danny50167/Space-to-Touch/README.md

# Space-to-Touch

시각장애인을 위한 **전방 공간 정보 → 촉각 변환 장치**.
머리에 착용한 ToF 거리 센서 3개(가로 한 줄)가 머리 높이의 전방을 측정하고, 진동 모터 3개가 장애물의 **방향**(왼쪽 / 가운데 / 오른쪽)과 **거리**를 진동으로 알려준다.

> 흰지팡이는 바닥의 장애물은 잘 찾지만 **허리 위 장애물(간판, 선반, 열린 창문 등)** 은 감지하지 못한다.
> 이 장치는 지팡이를 대체하는 것이 아니라, 지팡이가 못 하는 부분을 **보완**하는 것을 목표로 한다.

## 시스템 구성

```
 [머리 유닛]                               [몸 유닛]
 VL53L1X ×3 ── TCA9548A ── 4선 케이블 ──── ESP32 DevKitC ── 진동 모터 모듈 ×3
 MPU-6050 (고개 각도) ──────┘                    ┆ Wi-Fi
 (3D 프린팅 브래킷)    (3.3V, GND, SDA, SCL)   맥북 (데이터 기록)    (MOSFET 내장, VCC·GND·IN)
```

보드는 처음에 Arduino Mega로 정했다가, 걸으면서 하는 실험의 데이터를 무선으로 받으려고 ESP32로 바꿨다 (11/10). Mega·Uno는 예비이고 펌웨어는 세 보드 모두에서 돌아간다. 사용법은 `docs/esp32.md`.

센서 번호와 모터 번호는 같은 규칙을 쓴다. 멀티플렉서 채널 번호도 같다.

```
 왼쪽   가운데   오른쪽
  0       1       2      ← 머리 높이 (가로 한 줄)
```

처음에는 3×2(위 줄 + 허리 높이 아래 줄)로 설계했다가 머리 높이만 보는 1×3으로 바꿨다. 이유와 한계는 `docs/design-notes.md` 1-3장.

## 폴더 구조

| 경로 | 내용 |
|---|---|
| `docs/roadmap.md` | 작업 순서대로 정리한 할 일 목록, 단계마다 남길 기록 |
| `docs/design-notes.md` | 핵심 설계 쟁점과 계산 (센서 각도, 모터 위치, 진동 표현 방식) |
| `docs/wiring.md` | 배선도와 전원 설계 |
| `docs/esp32.md` | ESP32 설치, 첫 업로드, 무선으로 데이터 받기 (맥북) |
| `docs/parts.md` | 준비물 목록 (전자 부품, 기구 부품, 실험 도구) |
| `docs/logbook-template.md` | 설계 일지 양식 |
| `firmware/00_i2c_scan` | 부품 확인: I2C 장치 검사, 진짜 VL53L1X인지 확인, 멀티플렉서 채널별 검사 |
| `firmware/01_single_sensor_test` | 센서 1개: 거리 모드 비교, 정확도 측정 |
| `firmware/02_three_sensors_mux` | 센서 3개 + 멀티플렉서: 순차/연속 측정 비교, 갱신 속도 측정 |
| `firmware/03_motor_localization_test` | 진동 위치 인식 실험 (착용 부위 비교용) |
| `firmware/04_space_to_touch` | 통합 펌웨어 (센서 → 필터 → 진동 패턴) |
| `firmware/05_imu_tilt` | 고개 각도 측정: 가속도 / 자이로 / 상보 필터 비교, 예상 바닥 거리 |

## 시작하기

1. Arduino IDE에 ESP32 보드와 **"VL53L1X" (by Pololu)** 라이브러리를 설치한다 (`docs/esp32.md` 1장).
2. `firmware/00_i2c_scan`으로 부품을 확인한 뒤, `01_...` 부터 순서대로 업로드하며 진행한다. 각 스케치 맨 위 주석에 사용법이 있다.
3. 시리얼 모니터는 **115200 baud**, 줄 끝은 "새 줄(Newline)"로 설정한다.
4. 걸으면서 하는 실험은 무선으로 받는다 (`02`, `04`, `05`만 해당, `docs/esp32.md` 3장).

## 부품

전체 준비물은 [`docs/parts.md`](docs/parts.md) 참고.
