danny50167/Space-to-Touch/docs/design-notes.md

# 설계 노트

여기 적힌 숫자는 **출발점**이다. 최종 값은 실험으로 직접 정하고, 바꾼 이유를 일지에 남긴다.
면접에서 "왜 이렇게 설계했나요?"라는 질문에 답할 근거가 바로 이 기록이다.

---

## 1. 센서 각도 설계

### 1-1. 왜 각도를 줘야 하나
VL53L1X의 시야각(FoV)은 약 **27°** 이다. 거리 d에서 센서 하나가 보는 폭은 다음과 같다.

```
폭 = 2 · d · tan(27° / 2) ≈ 0.48 · d      (1 m 앞에서 약 48 cm)
```

센서를 3 cm 간격으로 **평행하게** 붙이면 1 m 앞에서 두 시야가 3 cm만 어긋나므로 **약 94% 가 겹친다.**
결국 3개가 같은 곳을 보게 되어 방향 정보가 사라진다.
→ **실험 과제:** 평행 배치 상태에서 물체를 좌우로 옮기며 3개 값이 얼마나 비슷한지 측정해 둔다 (문제 발견 데이터).

### 1-2. 가로 방향 (왼쪽 / 가운데 / 오른쪽)
- 출발점: 가운데 0°, 좌우 **±25°** (10/16, 처음 ±27°에서 변경). 전방 약 77°를 덮는다.
- 이웃한 두 센서 사이 각도를 φ, 센서 중심 간격을 s라 하면, 두 시야 사이의 사각지대는 다음 거리에서 닫힌다.

```
사각지대가 닫히는 거리 = s / (tan 13.5° − tan(φ − 13.5°))
```

- φ = 27°이면 분모가 0이 되어 **사각지대가 끝까지 닫히지 않는다.** 폭 s(약 2~3 cm)의 띠가 계속 남는다.
- 예 (s = 2.5 cm):

| φ | 전체 시야 | 사각지대가 닫히는 거리 | 1 m 앞 겹침 |
|---|---|---|---|
| 0° | 27° | 5 cm | 95% (평행 배치) |
| 20° | 67° | 20 cm | 21% |
| 25° | 77° | 68 cm | 2% |
| 27° | 81° | 닫히지 않음 (폭 2.5 cm 띠) | 0% |
| 30° | 87° | 닫히지 않음, 1 m 앞에서 8 cm 틈 | 0% |

- **s 구하는 법:** s는 이웃한 두 센서의 **센서 창(발광·수광부) 중심 사이 거리**다. 기판 중심이 아니다.
  - 기판을 나란히 붙일 때의 어림값: s ≈ 기판 폭 + 기판 사이 틈(PLA 벽 두께와 공차).
  - 정확한 값: Fusion 360에서 마운트를 그린 뒤 **Inspect → Measure**로 두 센서 창 중심 사이를 잰다.
  - 사각지대가 닫히는 거리는 s에 비례한다. s를 줄이면 사각지대가 짧아지므로 센서를 가능한 한 붙여 배치한다.
- **거꾸로 계산하기:** 사각지대가 거리 d에서 닫히게 하려면 φ = 13.5° + arctan(tan 13.5° − s / d). 예: s = 2.5 cm, d = 0.5 m → φ ≈ 24.3°.
- **학생이 정할 것:** 실측한 s로 표를 다시 계산하고, 25°와 27° 쐐기 블록을 실험으로 비교한다.
- 머리에 달기 때문에 사용자가 **고개를 돌려 주변을 훑을 수 있다.** 이 점이 머리 착용의 큰 장점이다.

### 1-3. 세로 방향: 왜 한 줄인가 (10/12 설계 변경)
처음에는 3×2 (위 줄 0°, 아래 줄 아래로 20°)로 설계했다. **가로 한 줄(1×3)** 로 바꿨다.

- **근거:** 이 장치의 목적은 흰 지팡이가 못 잡는 영역을 보완하는 것이다. 그중 가장 크게 다치는 곳은 **머리 높이**다. 한 줄만 머리 높이에 두면 센서·모터·배선이 절반이 되고, 마운트가 가벼워진다.
- **포기한 것:** 미국 장애인법(ADA) 설계 기준 307조는 바닥에서 약 **0.69 m ~ 2.03 m** 높이에서 튀어나온 물체를 지팡이로 감지하기 어려운 것으로 본다. 한 줄은 이 구간 중 **위쪽만** 덮는다. 가슴~허리 높이에 튀어나온 물체는 감지하지 못한다 → 1-4 한계에 적는다.

센서 높이를 H, 아래로 기울인 각을 θ, 시야 반각을 α = 13.5°라 하면, 수평 거리 x에서 시야가 덮는 높이는 다음과 같다.

```
아래 끝 = H − x · tan(θ + α)
위 끝   = H + x · tan(α − θ)
```

예: H = 1.55 m

| θ (아래로) | 0.5 m 앞 | 1.0 m 앞 | 1.5 m 앞 |
|---|---|---|---|
| 0° | 1.43 ~ 1.67 | 1.31 ~ 1.79 | 1.19 ~ 1.91 |
| 5° | 1.38 ~ 1.62 | 1.22 ~ 1.70 | 1.05 ~ 1.77 |
| 10° | 1.33 ~ 1.58 | 1.12 ~ 1.61 | 0.90 ~ 1.64 |

- θ를 키우면 더 낮은 곳까지 보지만, 가까운 거리에서 **머리 윗부분이 빠진다.**
- 센서는 정수리보다 Δh(키 − H)만큼 낮다. 그래서 아무리 각도를 줘도 아주 가까운 곳에서는 정수리 높이를 보지 못한다. 정수리 높이 물체를 놓치기 시작하는 거리는 다음과 같다.

```
놓치는 거리 x₀ = Δh / tan(α − θ)
```

- 정수리 높이 물체는 x₀보다 멀리 있을 때는 감지되다가, **x₀보다 가까워지면 시야에서 빠져 진동이 멈춘다.** 충돌 직전에 진동이 멈추면 위험하다.
- 그래서 x₀는 가장 강한 경고 거리(500 mm)보다 충분히 짧아야 한다.
- **출발점:** θ = 12° (10/16, 처음 0°에서 변경). v1 힌지로 0~15°를 바꿔 가며 실험한다.
  - 이유: θ가 작으면 시야 위쪽이 정수리보다 높은 곳에 낭비되고, 가까운 곳의 낮은 장애물을 덜 본다. θ가 반각 13.5°를 넘으면 시야 위 끝이 수평 아래로 내려가 가까운 이마 높이 물체를 놓친다. 그래서 위 끝이 거의 수평인 12~13°가 한 줄로 할 때 가장 좋다.
  - 12°와 13°의 차이(아래쪽 1~2 cm)는 걸을 때 고개 흔들림보다 작다. 최종값은 실험으로 정한다.
  - 남는 정수리 띠(센서보다 위 약 6 cm)는 각도 대신 센서 줄을 머리에서 **최대한 높게** 달아 줄인다.
- **학생이 정할 것:** 학생의 H와 키로 표와 x₀를 다시 계산하고, x₀가 경고 거리보다 충분히 짧은 범위에서 θ를 고른다.

### 1-4. 알려진 한계 (보고서에 꼭 적을 것)
- 한 줄(1×3)이라 **가슴~허리 높이에 튀어나온 물체는 감지하지 못한다** (1-3). 의도적으로 머리 높이를 우선한 결과다.
- 걸을 때 고개가 위아래로 ±10° 정도 흔들리면 센서 줄이 보는 높이도 같이 흔들린다.
  - MPU-6050으로 고개 각도를 재서 바닥 측정값을 거른다 (5장). 단, 시야 자체가 흔들리는 것은 막지 못한다.
- 유리, 거울, 검은 천은 적외선이 잘 반사되지 않아 측정이 부정확하다.
- 센서 시야가 겹치면 서로의 적외선이 간섭할 수 있다 → `02` 스케치로 순차 측정과 연속 측정을 비교한다.

### 1-5. 수학적 모델링: 시야 원뿔과 바닥이 만드는 이차곡선
센서 시야는 꼭짓점이 센서이고 반각이 α ≈ 13.5°인 **원뿔**이다. 아래로 θ만큼 기울이면, 바닥(평면)과 만나는 경계는 θ에 따라 달라진다.

| 기울기 | 바닥에 생기는 경계 | 의미 |
|---|---|---|
| θ > α (예: 고개를 20° 숙였을 때) | **타원** | 바닥에서 닫힌 영역을 본다 |
| θ = α | **포물선** | |
| θ < α (예: 출발점 0°) | **쌍곡선** | 시야 일부가 바닥에 닿지 않고 앞으로 뻗어 나간다 |

타원일 때 바닥 감지 영역의 앞뒤 경계(수평 거리)는 다음과 같다.

```
가까운 끝 = H / tan(θ + α)       먼 끝 = H / tan(θ − α)
가까운 끝까지의 직선거리 = H / sin(θ + α)
```

**설계 확인:** "가까운 끝까지의 직선거리"가 진동 경고 거리(2000 mm, 10/16 1500 mm에서 변경)보다 길어야, 장애물이 없어도 **바닥 때문에 진동이 울리는 오작동**이 생기지 않는다.
- sin 값은 1을 넘지 않으므로 이 거리는 항상 H 이상이다. 머리에서 바닥까지 가장 가까운 거리는 바로 아래 방향의 H이기 때문이다.
- 따라서 **H > 경고 거리이면 각도와 상관없이 바닥 오작동이 생기지 않는다.**
- 경고 거리를 2 m로 늘려서 H = 1.74 m < 2 m가 되었다. θ = 12°이면 고개를 약 35° 이상 더 숙일 때 바닥이 2 m 안에 들어온다 → MPU-6050으로 고개 각도를 재서 거른다 (5장).

**탐구 확장:** 센서 방향을 **공간벡터**로 놓고 원뿔의 방정식과 평면 z = 0을 연립하면 타원의 방정식을 직접 구할 수 있다.
바닥에 종이를 깔고 물체를 움직여 실제 감지 경계를 측정한 뒤 계산과 비교한다.

### 1-6. ROI 기능 (선택)
VL53L1X는 내부 16×16 SPAD 중 일부만 쓰도록 **ROI(관심 영역)** 를 줄일 수 있다 (`setROISize`).
ROI를 줄이면 시야각이 좁아져 겹침이 줄어드는 대신 신호가 약해진다. 각도 조정과 비교해 볼 수 있는 대안이다.

---

## 2. 진동 모터 착용 위치

센서는 머리에 달지만 모터를 꼭 머리에 달 필요는 없다. **데이터로 정한다.**

| 후보 | 예상 장점 | 예상 단점 |
|---|---|---|
| 이마 (헤드밴드) | 센서와 같은 위치라 가장 직관적 | 진동이 두개골을 타고 퍼짐, 세로 간격 확보가 어려움, 불쾌감 |
| 팔뚝 (슬리브) | 착용이 쉬움 | 폭이 좁아 가로 3칸 배치가 어려움, 좌우 대응이 덜 직관적 |
| 복부 (벨트) | 넓어서 간격 확보가 쉽고 좌우 대응이 자연스러움 | 옷 위에서는 진동이 약해짐 |

- 모터 간격은 **4~5 cm 이상**에서 시작한다. 진동 자극은 정적 압력보다 위치 구분이 어렵다.
- (가안, 진동 모터 단계에서 다시 정한다) 모터가 3개뿐이라 어느 부위든 정확도가 100%에 가깝게 나올 수 있다. 그러면 부위끼리 비교가 안 되므로, **모터 간격(예: 2 / 4 / 6 cm)** 을 변수로 추가하는 방법을 검토한다.
- 모터와 밴드 사이에 **폼이나 실리콘을 넣어 진동이 옆으로 퍼지지 않게** 한다 (진동 격리).
- **실험:** `03_motor_localization_test`로 부위별 위치 인식 정확도와 혼동 행렬을 비교한다. 어느 모터끼리 헷갈리는지가 드러난다.

### 물리·생명 연계
- 코인 모터(ERM)는 **편심 질량의 회전**으로 진동한다. 원심력은 F = m·r·ω² 이다.
  - 그래서 진동 세기와 진동수를 따로 조절할 수 없다 (전압을 올리면 둘 다 커진다). 이것이 ERM의 구조적 한계다.
- 피부의 **파치니 소체**는 약 200~300 Hz 진동에 가장 민감하다. 사용하는 모터의 진동수와 비교해 볼 것.
- 같은 자극이 계속되면 **감각 순응**으로 둔해진다 → "먼 물체는 진동하지 않음" 설계의 근거가 된다.

---

## 3. 거리 → 진동 표현 방식

사람은 진동 **세기**의 차이보다 **리듬(간격)** 의 차이를 더 잘 구분한다. 자동차 후방 경고음과 같은 방식을 쓴다.

| 단계 | 거리 (출발점) | 패턴 |
|---|---|---|
| 0 | 2000 mm 이상 / 감지 없음 | 진동 없음 |
| 1 | 1000 ~ 2000 mm | 짧게 "띠…" (80 ms 켜짐 / 700 ms 주기) |
| 2 | 500 ~ 1000 mm | "띠띠띠" (80 ms / 300 ms) |
| 3 | 500 mm 미만 | 계속 진동 |

- **중앙값 필터 (3개):** 튀는 값 하나를 무시한다.
- **히스테리시스 (50 mm):** 경계 거리에서 단계가 깜빡이지 않게 한다. 가까워질 때는 즉시 반응하고, 멀어질 때만 여유를 둔다.
- **사라진 물체 경고 유지 (TTC, 미적분Ⅰ 탐구, 학생이 직접 구현):** 센서 줄이 한 줄이라 낮은 물체는 가까워지면 시야 아래로 빠진다 (예: θ = 12°이면 가슴 높이 1.3 m는 0.92 m부터 놓친다). 진동이 멈추면 사용자는 "앞이 비었다"고 오해한다.
  - 센서마다 마지막 거리 d와 접근 속도 v(최근 Δt 동안의 평균변화율)를 기억한다.
  - 2 m 안의 물체가 갑자기 "감지 없음"이 되거나 한 번에 30 cm 이상 멀어지고, 직전 v ≥ 0.2 m/s였으면 "시야에서 빠졌다"로 본다.
  - 그 뒤에는 예측 거리 = d − v × (지난 시간)으로 단계를 정해 진동을 이어 간다.
  - 끝내는 조건: 예측 거리 ≤ 0 (TTC = d ÷ v가 지남), 최대 2초, 센서가 다시 실제 값을 볼 때(실제 값이 항상 우선), (선택) 자이로로 고개를 옆으로 돌린 것이 잡힐 때.
  - 없는 물체에 잠깐 더 울리는 것이 있는 물체에 안 울리는 것보다 안전하다 (fail-safe).
- **고장 알림:** 센서가 응답하지 않으면 모든 모터를 짧게 두 번 울린다. 고장 상태에서 아무 진동이 없으면 사용자는 "앞이 비었다"고 오해한다 → **안전 설계(fail-safe)**.

### 반응 속도
- 실내에서 안대를 쓰고 걸으면 보행 속도는 약 0.7 m/s다.
- 연속 측정 모드에서 센서들은 **동시에** 측정하므로 각 센서가 약 20 Hz로 갱신된다 (타이밍 버짓 50 ms 기준).
- 순차 측정이면 3배 느려진다. 두 방식의 측정값을 `02` 스케치로 직접 비교할 것.

---

## 4. 기구 설계 (PLA 3D 프린팅)

### 4-1. PLA의 특성과 대응
| PLA 특성 | 대응 |
|---|---|
| 딱딱하고 거의 휘지 않음 | 머리 곡면에 직접 닿지 않게 하고, **고프로 호환 헤드 스트랩에 부착**한다. 머리에 닿는 면에는 폼을 붙인다 |
| 진동을 잘 전달함 | 모터 홀더끼리 **PLA로 연결하지 않는다.** 홀더를 하나씩 따로 고무 밴드에 달고, 바닥에 폼을 깐다 |
| 층과 층 사이가 약함 | 힌지나 볼트 구멍처럼 힘을 받는 부분은 **층이 쌓이는 방향과 힘의 방향**을 고려해 출력 방향을 정한다 |
| 출력 오차 | 볼트 구멍은 +0.2~0.3 mm 크게, 너트는 육각 포켓에 끼우는 구조로 |

### 4-2. 헤드 마운트: v1 각도 조절형 → v2 고정형
처음부터 계산한 각도로 고정하면, 계산이 틀렸을 때 다시 출력해야 한다.

- **v1 (실험용):** 각도를 바꿀 수 있게 만든다. 예시 구조:
  - 세로 기울기: 센서 3개를 하나의 바에 달고, 바 뒤에 **고프로 마운트 손가락(2발)** 을 만든다. 헤드 스트랩 이마 쪽의 3발 마운트에 끼우고 **M5 나비볼트**로 조여 마찰로 고정한다. 0~15°를 바꿀 수 있게 하고(출발점 12°), 측면에 각도 눈금을 새긴다 (Fusion 360 Emboss).
    - 10/16 결정: 처음에는 바 양 끝에 M3 볼트 힌지를 따로 설계하려 했다. 헤드 스트랩의 고프로 마운트가 이미 나사로 조이는 힌지라서, 이를 그대로 쓰면 설계가 단순해진다.
    - 손가락 두께, 손가락 사이 간격, 구멍 지름(약 5 mm), 손가락 끝까지 높이는 받은 스트랩을 캘리퍼스로 재서 정한다. 인터넷 치수보다 실측을 믿는다.
    - 위쪽 끈(탑 스트랩)이 앞이 무거운 센서 유닛이 처지는 것을 막는다.
  - 가로 벌림: 센서와 바 사이에 **교체형 쐐기 블록**(0°, 15°, 20°, 25°, 30°)을 끼운다.
  - **0° 블록**을 끼우면 평행 배치가 된다. 같은 마운트로 평행 배치 실험(3단계)과 부채꼴 배치 실험을 모두 할 수 있다.
- **v2 (최종):** v1 실험으로 찾은 각도를 반영한 일체형. 가볍고 튼튼하다.
- v1 → v2 과정 자체가 "실험으로 설계값을 정하는" 공학 설계 과정의 기록이 된다.

### 4-3. 무게와 무게중심
- 머리 유닛이 이마 앞으로 많이 튀어나오면 목에 걸리는 **돌림힘(토크) = 무게 × 거리**가 커진다.
- 센서 배열을 이마에 최대한 붙이고, ESP32와 확장보드는 뒤통수에 두어 균형을 맞춘다 (4-7).
- Fusion 360의 질량 속성(Properties)으로 무게와 무게중심을 확인하고 (PLA 밀도 약 1.24 g/cm³, 채움률 반영), 실제 저울 측정값과 비교한다.

### 4-4. 센서 장착 시 주의
- 센서 앞 유리창(발광부, 수광부)을 **가리지 않도록** 개구부를 충분히 크게 만든다. PLA 벽이 시야각 안에 들어오면 그 벽까지의 거리가 측정된다.
- 센서 모듈 뒷면 부품이 닿지 않도록 스페이서를 둔다.

### 4-5. 센서 모듈 치수 (판매처 도면, 10/16)
| 항목 | 값 |
|---|---|
| 전체 폭 (둥근 윗부분) | 20 mm |
| 전체 높이 | 12 mm (윗부분 8.5 mm + 핀 부분 3.5 mm) |
| 핀 부분 | 폭 15 mm, 핀 6개, 간격 2.54 mm |
| 장착 구멍 | 지름 2 mm × 2개 (M2), 중심 간격 16 mm → 양옆 가장자리에서 2 mm |
| 장착 구멍 세로 위치 | 위 가장자리에서 약 4.3 mm (도면 비율로 읽은 값 → **실측 확인**) |
| 부품 영역 (타원) | 12 × 8.5 mm, 가로 가운데 |
| 센서 칩 중심 위치, 기판 두께, 뒷면 부품 높이, 핀헤더 방향과 길이 | 도면에 없음 → **실측** |

- PLA 구멍: M2 볼트가 통과할 구멍은 2.3~2.4 mm, 볼트를 바로 박아 넣을 구멍은 1.7~1.8 mm에서 시작해 시험 출력으로 맞춘다.
- **센서 앞에는 아무것도 두지 않는 구조**가 가장 간단하다. 기판을 뒤에서 스페이서 2개와 M2 볼트로 받치면 시야를 가릴 걱정이 없다.
- **s 어림값:** 기판을 가로로 놓으면 폭 20 mm + 틈 → s ≈ 22 mm. 세로로 세우면(90° 회전) 폭 12 mm + 틈 → s ≈ 14 mm.
  - φ = 25°일 때 사각지대가 닫히는 거리: 가로 약 60 cm, 세로 약 38 cm.
  - 세로로 세우면 센서 줄 전체 폭도 줄어 가볍다. 단, 핀헤더와 점퍼선이 옆 센서와 부딪히지 않는지 확인한다.

### 4-6. MPU-6050 (GY-521) 치수와 장착 (10/16, 판매처 표기 + 추정)
도면: [`docs/img/gy521.svg`](img/gy521.svg)

| 항목 | 값 | 출처 |
|---|---|---|
| 기판 크기 | 21.2 × 16.4 mm (판매처에 따라 20~21 × 15~16 mm) | 판매처 표기 |
| 두께 | 부품 포함 약 3.3 mm (핀 제외) | 판매처 표기 |
| 장착 구멍 | Ø3 mm (M3) 2개, 간격 약 15.5 mm, 핀 반대쪽 긴 변 | 판매처 1곳 + 추정 → **실측** |
| 핀 | 8개 (VCC, GND, SCL, SDA, XDA, XCL, AD0, INT), 간격 2.54 mm, 긴 변 한쪽 | 판매처 표기 |

- 판매처마다 크기가 조금씩 다르다. **학생이 가진 기판을 캘리퍼스로 재서** 구멍 위치와 함께 확정한다.
- 한쪽 구멍은 옆 부품 때문에 볼트 머리가 안 들어가는 제품이 있다고 한다. 그러면 볼트 1개 + 반대쪽에 턱(걸쇠)을 두어 돌아가지 않게 한다.
- **단단히 고정한다.** 폼이나 양면 스펀지 테이프를 깔면 흔들림까지 각도로 잰다.
- 센서 바에 기판 외형 + 0.3 mm 크기의 얕은 홈(약 1 mm)을 파서 위치를 잡고, 뒷면 납땜 자국이 닿지 않게 스페이서(약 2 mm)를 둔다.
- 기판의 X축 화살표가 앞(센서가 보는 쪽)을 향하게 놓는다. 핀헤더 방향에 따라 점퍼선이 나갈 공간을 남긴다.
- 위치: 가운데 센서 뒤쪽 센서 바. 고프로 마운트 나사를 돌릴 공간은 비워 둔다.

### 4-7. 전체 배치: 무엇을 몸 어디에 두나 (11/13, 출발점)
**원칙:** 약한 신호(I2C)는 짧게, 튼튼한 선(USB 전원, 모터 ON/OFF)은 길어도 된다.

```
        [앞] 이마
   센서 바: 센서 0·1·2 + TCA9548A + MPU-6050
   (고프로 마운트, 센서 바 뒤)
     │ 왼쪽 띠: I2C 4선          │ 오른쪽 띠: 모터 선
     │ (3.3V·GND·SDA·SCL)        │ (G·V·S × 3)
        [뒤] 뒤통수
   뒤판: ESP32 + 확장보드
     │ USB 선 (목 뒤 → 등)
   주머니·허리: 보조배터리
```

| 부품 | 자리 | 이유 |
|---|---|---|
| 센서 3개, TCA9548A, MPU-6050 | 이마 앞 센서 바 | MPU-6050은 센서와 같이 기울어야 한다. TCA9548A를 여기 두면 뒤로 가는 선이 4가닥뿐이다 |
| ESP32 + 확장보드 | 뒤통수 (헤드 스트랩 뒤 띠) | I2C 선이 30~40 cm로 짧다. 앞쪽 센서 바와 무게가 반대쪽이라 목에 걸리는 돌림힘이 줄어든다. 안테나가 몸에 가리지 않는다 |
| 보조배터리 | 주머니 또는 허리 | 머리에 올리기엔 무겁다. 케이블 하나(USB)만 내려오면 된다 |
| 진동 모듈 3개 | 착용 위치 실험(4단계) 후 결정 | 아래 "모터 선" 참고 |

**버린 안: ESP32를 허리에 두기.** 처음 문서는 ESP32를 몸 유닛으로 생각했다. 그러면 I2C 선이 머리에서 허리까지 1 m가 넘는다. 걸을 때 점퍼선 커넥터가 흔들리면 I2C가 멈출 수 있다. 모터 위치가 복부로 정해지면 이 안을 다시 검토할 수 있다. 그때는 아래 "확인 실험 2"를 1 m 선으로 해 보고 정한다.

**선 길이**
- 앞 마운트에서 뒤판까지 끈을 따라 실이나 줄자로 잰다. 머리둘레의 절반 정도(약 28~30 cm)다. 여유 5 cm를 더한다.
- 산 점퍼선은 30 cm다. 모자라면 집에 있는 전선으로 4선 케이블을 만들고 양 끝에 핀헤더를 납땜한다 (열수축 튜브로 감싼다). 암–암 점퍼선끼리는 바로 이을 수 없다.
- I2C 묶음(왼쪽)과 모터 선(오른쪽)은 머리 반대편으로 돌린다. 모터 선의 전류가 I2C에 잡음을 넣을 기회를 줄인다.

**모터 선** (착용 위치에 따라)
| 착용 위치 | 연결 |
|---|---|
| 이마 | 뒤판 → 오른쪽 띠 → 센서 바 아래 모듈 3개. 길이는 I2C와 비슷하다 |
| 팔뚝·복부 | 뒤판에서 목 뒤로 5선 케이블(GND, 5V, IN 0·1·2)을 USB 선과 함께 내린다. 약 1 m |

- 1 m 선의 전압 강하 어림: 가는 점퍼선 저항을 1 m당 약 0.2 Ω으로 보면 왕복 2 m ≈ 0.4 Ω. 모터 3개 기동 전류 약 0.27 A → 약 0.1 V. 문제없다.
- ON/OFF 신호(PWM)는 I2C와 달리 1 m에서도 괜찮다.

**전원 선 (USB)**
- 보조배터리 → ESP32 마이크로 USB. 1 m 안팎의 짧고 굵은 선을 쓴다.
- 최대 전류 약 0.55 A(`wiring.md` 3장). 얇은 선은 1 m에서 0.2 V 넘게 떨어질 수 있다.
- **마이크로 USB 단자는 잘 부러진다.** 뒤판에서 케이블을 케이블타이로 판에 한 번 묶어, 당겨도 힘이 단자가 아니라 판에 걸리게 한다. 모든 선 묶음에 같은 방법을 쓴다.

**뒤판 (학생 설계, PLA)**
- 확장보드를 M3 볼트와 스페이서(뒷면 납땜이 닿지 않게 3~5 mm)로 고정한다. 확장보드 크기와 구멍 위치는 판매 페이지에 없어서 **받으면 캘리퍼스로 잰다.**
- 판 양쪽에 스트랩이 지나갈 **슬롯 2개**를 둔다. 스트랩 폭과 두께를 재서 +1 mm로 시작한다.
- 머리에 닿는 면에는 폼을 붙인다. 벽에 기대도 보드가 눌리지 않게 위에 덮개를 둔다 (열이 빠지게 옆은 연다).
- USB 단자와 리셋·부트 버튼에 손이 닿게 연다.
- v2에서는 확장보드 대신 만능기판에 필요한 핀만 납땜하면 작고 가벼워진다.

**무게중심 (4-3 이어서)**
- 고개를 끄덕이는 축(귀 높이 근처)을 기준으로 앞 유닛과 뒤 유닛의 돌림힘을 비교한다.
  - 앞: m앞 × d앞 (센서 바 무게 × 축에서 앞까지 거리)
  - 뒤: m뒤 × d뒤 (뒤판 + 보드 무게 × 축에서 뒤까지 거리)
- 각 유닛을 주방 저울로 재고, 거리는 착용한 사진이나 줄자로 잰다. 두 값이 비슷할수록 앞으로 처지지 않는다. 지어낸 값이 아니라 **잰 값**으로 일지에 쓴다.

**확인 실험** (부품이 오면, 결과는 일지에)
1. 전압: 보조배터리로 켜고 모터 3개를 모두 켠 상태에서 ESP32 5V 핀과 GND 사이 전압을 멀티미터로 잰다. 4.5 V 이상이면 된다. 4.4 V 아래면 더 짧고 굵은 USB 선으로 바꾼다 (ESP32의 3.3V 레귤레이터가 버티지 못해 재시작할 수 있다).
2. I2C 안정성: 착용하고 벽을 1 m 앞에 둔 채 `02`로 무선 기록한다. 가만히 1분 → 고개를 흔들고 선을 살짝 당기며 1분을 비교한다. `-1`(무효값) 수와 갱신이 멈추는 순간이 있는지 본다. `-1`은 물체가 범위 밖일 때도 나오므로 벽 앞에서 한다. 괜찮으면 10분 걸으며 기록해 갱신이 멈추지 않는지 확인한다.

---

## 5. 고개 각도 센서 (MPU-6050, 10/16 추가)

### 5-1. 왜 넣나
- 걸을 때 고개가 끄덕이고 머리끈이 미끄러져서 센서 각도가 바뀐다.
- 고개를 많이 숙이면 바닥이 경고 거리 안에 들어와 **바닥 때문에 진동이 울린다.** H = 1.74 m, θ = 12°이면 고개를 약 35° 이상 더 숙일 때 바닥이 2 m 안으로 들어온다.
- **해결되는 것:** 바닥 측정값을 계산으로 걸러낸다.
- **해결되지 않는 것:** 각도를 *알 뿐* 시야를 고정하지는 못한다. 고개를 숙이는 동안은 정수리 높이를 못 보는 것이 그대로다.
- **하지 않는 것:** 낭떠러지(내려가는 턱) 경고. 흰 지팡이가 가장 잘 찾는 것이라 이 장치의 목적(지팡이가 못 잡는 것을 보완)과 맞지 않는다.

### 5-2. 각도 계산 (`firmware/05_imu_tilt`)
센서 X축이 앞, 아래로 숙인 각도를 p라 하면:

```
가속도: X축에 걸리는 중력 성분 = −g·sin p   →   p = atan2(−aₓ, √(a_y² + a_z²))
자이로: p ← p + ω·Δt                         (회전 속도를 더한다 = 적분)
상보 필터: p ← α·(p + ω·Δt) + (1 − α)·p_가속도   (α 출발점 0.98)
```

- 가속도 각도는 가만히 있으면 정확하지만 걸을 때 발걸음 충격 때문에 튄다.
- 자이로 각도는 부드럽지만 작은 영점 오차가 계속 더해져 시간이 지나면 어긋난다(드리프트).
- 상보 필터는 짧은 시간에는 자이로를, 긴 시간에는 가속도를 믿는다. α가 클수록 자이로를 더 믿는다.

### 5-3. 바닥 거르기
```
센서가 아래를 보는 각도 β = θ(장착 각도) + p(고개 숙임)
예상 바닥 거리 = H / sin(β + 13.5°)
측정값 ≥ 예상 바닥 거리 − 여유  →  바닥으로 보고 진동하지 않는다  (여유 출발점 150 mm)
```

- 센서는 시야 안에서 값 하나만 내놓는다. 바닥과 장애물이 한 시야에 같이 있을 때 어떤 값이 나오는지는 실험으로 확인한다 (5단계 감지 영역 검증).
- **후속 탐구 (3학년 물리):** 상보 필터 α와 각도 오차의 관계를 정량 분석하고, 칼만 필터와 비교한다.
