danny50167/Space-to-Touch/docs/roadmap.md

# 할 일 목록

**원칙:** 매 단계마다 "측정 → 문제 발견 → 원인 분석 → 개선"을 기록한다. 실패한 시도도 반드시 남긴다.

> 기한은 두지 않는다. 위에서부터 순서대로 진행한다.
> ⭐ 표시는 교과 탐구(물리, 생명, 미적분Ⅰ) 실험이다.
> 진행판: https://claude.ai/artifact/6FQgMdCzBTvjgwHaMFwMRJ — 여기서 체크한 것을 이 문서에도 옮긴다.

---

## 1. 부품 준비
- [ ] docs/parts.md 목록을 보고 부족한 것을 확인하고 주문한다
- [x] 디바이스마트 주문: ESP32 ×2, 확장보드, 진동 모듈 ELB060416 ×4, 74HCT125 등 (11/13, `docs/purchases-2026-11.xlsx`)
- [x] 쿠팡 로켓배송 주문: 헤드 스트랩, 캘리퍼스, 고탄력 밴드 (11/13)
- [ ] 남은 구매: 육각렌치 1.5 mm(없으면), 고프로 나비나사(스트랩에 없으면). 맥북 연결은 가진 USB 허브 + USB-A ↔ 마이크로 케이블을 쓴다. 스트랩이 오면 마운트 손가락 두께·간격·구멍 지름을 잰다
- [ ] ESP32 처음 써 보기: 보드 설치 → 첫 업로드 → 무선 기록을 맥북으로 받기 (`docs/esp32.md` 1~4장)
- [ ] 가진 부품 점검: 센서 6개를 ESP32(3.3V)에 연결해 `00_i2c_scan`으로 확인해 상태 좋은 3개를 고르고, MPU-6050(0x68)도 확인, 모터 사양(rpm) 기록, phyphox 측정률 확인
- [ ] 센서와 멀티플렉서에 핀헤더 납땜, 암–암 점퍼선 준비
- [x] 진동 모터 교체 결정: 리드선이 가는 코인 모터 → MOSFET 내장 진동 모터 모듈 (`docs/parts.md`)
- 참고: 필요한 부품은 국내 쇼핑몰(1~3일 배송)에서 미리 산다. 자세한 목록은 docs/parts.md.

---

## 2. 센서 1개 이해하기
- [ ] 라이브러리 설치, `01_single_sensor_test` 업로드
- [ ] 거리 모드(Short / Medium / Long)별로 실제 거리 30, 50, 100, 150, 200 cm에서 평균과 표준편차 측정
- [ ] 흰 종이 / 검은 천 / 유리처럼 표면을 바꿔 측정
- [ ] 밝은 곳(창가)과 어두운 곳에서 200 cm가 제대로 재지는지 확인 (경고 시작 거리 2 m)
- **기록:** 실측값 vs 측정값 표와 오차 그래프 → 사용할 거리 모드와 그 이유
- 연계: 빛의 속력과 비행시간 (1 m 왕복 ≈ 6.7 ns)

---

## 3. 센서 3개 + 멀티플렉서
- [ ] 멀티플렉서 배선, `02_three_sensors_mux` 업로드
- [ ] **평행 배치**에서 물체를 좌→우로 옮기며 3개 값 기록 → 방향 구분이 안 되는 것을 데이터로 확인 (**핵심 "문제 발견"**)
- [ ] 순차 측정 vs 연속 측정: 갱신 속도(Hz)와 값의 흔들림(표준편차) 비교
- [ ] ⭐ **(미적분Ⅰ)** 접근 실험: 센서 하나를 들고 벽을 향해 느리게 / 보통 / 빠르게 걸으며 `02` 스케치의 CSV(시간, 거리)를 무선으로 저장 (`docs/esp32.md` 3장). 속도마다 3회 이상
- [ ] ⭐ **(미적분Ⅰ)** 접근 실험 분석: 평균변화율로 접근 속도를 구하고 "충돌까지 남은 시간 = 거리 ÷ 접근 속도" 계산. Δt를 바꾸면 잡음과 반응 지연이 어떻게 달라지는지 비교
- 참고: v1 마운트가 먼저 나왔으면 0° 쐐기 블록을 끼워 평행 배치를 만든다. 아직 없으면 판에 센서를 나란히 붙인다.
- **기록:** 평행 배치의 겹침 문제 데이터, 측정 방식 결정과 그 이유, 접근 실험 CSV와 분석

---

## 4. 진동 모터와 착용 위치 실험
- [ ] 진동 모터 모듈 3개 배선 (`docs/wiring.md` 2장), 모듈 기판을 보고 회로도 그리기
- [ ] ⭐ **(물리)** 모터 진동 특성 측정: 스마트폰을 모터에 붙이고 phyphox(가속도 센서)로 듀티비별 진동수와 진폭 측정
- [ ] 모터 3개를 이마 / 팔뚝 / 복부에 임시로 붙인다 (테이프, 밴드)
- [ ] ⭐ **(생명)** `03_motor_localization_test`: 부위마다 30회 시행, 참가자 2~3명
- [ ] 참가자는 안대와 백색소음 이어폰 착용 (모터 소리로 위치를 맞히지 못하게 통제)
- [ ] ⭐ **(생명)** 두 점 역치: 같은 참가자, 같은 부위에서 컴퍼스로 측정해 진동 위치 인식 결과와 비교
- **기록:** 듀티비–진동수 그래프, 부위별 정확도와 혼동 행렬 → 착용 위치 결정 (데이터 기반 설계 결정)
- 연계: 편심 회전의 원심력 (물리), 피부 감각 수용기와 감각 순응 (생명)
- 가안: 모터가 3개라 부위마다 정확도가 100%에 가깝게 나오면, 모터 간격(2 / 4 / 6 cm)을 변수로 추가한다 (`design-notes.md` 2장)

---

## 5. Fusion 360 기구 설계 (PLA)
- [ ] 10/12~16 설계 변경(1×3, 좌우 ±25°, 세로 12°, 경고 2 m, MPU-6050 추가, 낭떠러지 경고 제외)과 11/10 보드 변경(ESP32, 무선 기록)의 이유를 설계 일지에 쓴다
- [ ] 키와 감지 높이로 센서 각도 계산 (`docs/design-notes.md` 1장)
- [ ] 센서 홀더: 칩 중심 위치·기판 두께·뒷면 부품 높이·핀헤더 방향을 재고, 홀더 1개를 그려 시험 출력 (M2 구멍 공차, 시야를 가리지 않는지 확인)
- [ ] 헤드 마운트 v1 = 각도 조절형: 센서 바 뒤의 고프로 마운트 손가락과 M5 나비볼트로 0~15° 기울이고(출발점 12°), 좌우는 쐐기 블록(0°·25°부터)으로 바꿀 수 있게 설계. 바에 MPU-6050 자리, 센서 줄은 머리에서 최대한 높게 (`design-notes.md` 4장)
- [ ] 전체 배치 (`design-notes.md` 4-7): 스트랩을 쓰고 앞 마운트 → 뒤통수 선 경로 길이를 재고, 확장보드 크기·구멍을 재서 뒤판(ESP32 받침, 스트랩 슬롯)을 설계한다. 앞·뒤 유닛 무게를 저울로 재서 돌림힘을 비교한다
- [ ] 실험으로 최적 각도 찾기 → v2 = 그 각도로 고정한 일체형
- [ ] 진동 밴드: PLA 모터 홀더 + 고무 밴드 + 폼 진동 격리
- [ ] ⭐ **(물리)** 진동 격리 검증: phyphox로 옆 모터 위치에서 진동이 얼마나 전달되는지 측정 (폼 있음 / 없음)
- [ ] 감지 영역 검증: 센서 줄이 감지하는 높이 범위와 바닥 경계를 측정하고 계산값(원뿔·이차곡선)과 비교
- **기록:** 설계 도면 캡처, 계산 과정, 계산값 vs 실측값, 진동 전달률 비교
- 참고: 가장 오래 걸리는 단계라 미루지 않는다. 1~2단계와 병행한다. 머리 유닛 무게와 무게중심(목 부담), 착용 편의도 고려한다.

---

## 6. 통합
- [ ] `04_space_to_touch` 업로드, 거리 기준값과 패턴 조정
- [ ] 착용 상태 점검: 보조배터리로 모터 3개를 켠 채 ESP32 5V 핀 전압을 멀티미터로 재고(4.5 V 이상), 벽 앞에서 고개를 흔들고 선을 당기며 `02`로 I2C가 멈추지 않는지 확인 (`design-notes.md` 4-7)
- [ ] 필터와 히스테리시스를 넣기 전과 후의 진동 깜빡임 비교
- [ ] ⭐ **(미적분Ⅰ)** 사라진 물체 경고 유지: 3단계에서 정한 Δt로 접근 속도를 구하고, 물체가 시야에서 빠지면 충돌까지 남은 시간(TTC) 동안 예측 거리로 진동을 유지한다 (학생이 직접 구현, `design-notes.md` 3장)
- [ ] ⭐ **(미적분Ⅰ)** 가슴 높이 상자로 접근 실험: 유지 기능 전과 후에 진동이 멈추는 거리 비교, 일차(TTC = 거리 ÷ 속도)와 이차함수 근사(근으로 충돌 시각 예측) 비교
- **기록:** 조정한 파라미터와 이유, 경고 유지 전후 비교

---

## 7. 고개 각도 센서 (MPU-6050)
- [ ] MPU-6050 배선 (`docs/wiring.md` 4장), `05_imu_tilt` 업로드, 고개를 숙이면 각도가 +로 커지는지 확인
- [ ] 가만히 있을 때와 걸을 때 가속도 각도 / 자이로 각도 / 상보 필터 각도를 CSV로 저장해 비교, 상보 필터 α 정하기
- [ ] 고개 각도로 예상 바닥 거리를 계산해 바닥 측정값을 거르는 기능을 `04`에 넣고, 고개를 숙이고 걸을 때 오작동을 넣기 전과 후로 비교
- **기록:** 세 각도 비교 그래프, α를 정한 이유, 바닥 오작동 전후 비교
- 연계: 중력 성분 분해(sin, cos), 적분과 드리프트. 학생이 각도 계산식을 손으로 따라가 일지에 남긴다 (`design-notes.md` 5장)

---

## 8. 1차 사용자 실험
- [ ] 실내 장애물 코스 제작 (머리 높이 장애물 포함, 매번 배치를 바꿈)
- [ ] 안대 착용 참가자: 장치 없음 vs 장치 착용 → 충돌 횟수, 통과 시간
- [ ] **안전:** 옆에 반드시 보조자가 있고, 장애물은 부딪혀도 다치지 않는 것(종이 상자, 풍선)만 쓴다
- **기록:** 결과 표, 참가자 의견 → v2 개선 목록

---

## 9. v2 개선과 재실험
- [ ] 가장 큰 문제 1~2개만 개선해서 같은 조건으로 재실험
- [ ] 시연 영상 촬영
- [ ] (가능하면) 시각장애인 복지관에 시연하거나 의견 요청

---

## 10. 보고서와 마무리
- [ ] 활동 보고서: 문제 정의 → 설계 → 시행착오 → 결과 → 한계와 후속 탐구
- [ ] 저장소 정리, 발표 자료
- [ ] 한계와 후속 탐구 정리 (3학년 교과 탐구로 이어질 주제)
