danny50167/Space-to-Touch/docs/log/2026-10-16.md

## 2026-10-16  (작업 시간: __시간)

> 초안: 결정 내용과 계산은 Claude가 정리했다. **원인 분석, 내 생각, 작업 시간은 학생이 직접 쓴다.**
> 10/12에 정한 것(1×3, 0° 쐐기 블록, 진동 모듈 수량)도 함께 적는다.

### 오늘의 목표
- Fusion 360 설계를 시작하기 전에 센서 배치(가로·세로 각도)와 경고 거리를 정한다.

### 한 일
- 센서 모듈 도면(판매처)에서 치수를 읽어 기록했다 (`design-notes.md` 4-5).
- 센서 배치를 위·옆·앞에서 보는 도면 페이지로 각도를 바꿔 가며 비교했다.
- 센서 각도, 경고 거리, 바닥 조건을 계산했다 (H = 1.74 m, 키 1.80 m, 시야각 27° → 반각 α = 13.5°).
- MPU-6050 측정 스케치(`firmware/05_imu_tilt`)를 준비했다.

### 측정 데이터
없음. 오늘은 계산만 했다. 계산 결과는 아래 "결정한 것과 이유"에 있다.

### 문제 / 예상과 달랐던 점
1. **"±27°면 빈틈 없이 덮는다"는 틀렸다.** 이웃한 시야의 가장자리가 평행해져서 센서 간격 s(약 22 mm)만큼의 띠가 끝까지 남는다.
2. **"시야 위 끝이 정수리보다 높아야 한다"는 조건은 만족할 수 없다.** 센서가 정수리보다 6 cm 낮아서 아주 가까운 곳에서는 어떤 각도로도 정수리 높이를 못 본다. → 정수리 높이를 놓치기 시작하는 거리 x₀ = 6 cm ÷ tan(α − θ)로 기준을 바꿨다.
3. **도면 그래프의 착시.** θ = 12°에서 그래프로는 정수리 높이를 다 보는 것처럼 보였지만, 실제로는 x₀ = 229 cm였다. 6 cm 차이가 그림에서는 7 픽셀이라 보이지 않았다.
4. **각도를 바꿔도 가까운 곳에서 보는 높이 폭은 거의 그대로다.** 0.5 m 앞에서 원뿔 하나가 덮는 높이는 θ와 상관없이 약 25 cm다. θ는 이 띠를 위아래로 옮길 뿐이다.
5. **경고 거리를 늘리자 바닥 조건이 깨졌다.** 머리에서 바닥까지 가장 가까운 거리는 H(1.74 m)다. 경고 거리가 1.5 m일 때는 바닥이 절대 경고 범위에 못 들어왔지만, 2 m로 늘리자 고개를 약 35° 더 숙이면 들어온다.

### 원인 분석 (어떤 원리로 설명되는가? 교과 개념과 연결되는가?)
(학생이 쓴다. 참고할 개념: 원뿔과 평면이 만나는 이차곡선, 삼각비(tan, sin)로 높이와 거리 구하기, 평행선과 사각지대, 중력 성분 분해)

### 결정한 것과 이유

**1. 센서 배치 3×2 → 1×3 (10/12)**
- 이유: 장치의 목적은 흰 지팡이가 못 잡는 영역을 보완하는 것이다. 그중 가장 크게 다치는 머리 높이를 우선한다. 센서·모터·배선이 절반이 되고 마운트가 가벼워진다.
- 포기한 것: 지팡이 사각지대(ADA 307: 바닥에서 0.69~2.03 m) 중 가슴~허리 높이. 보고서 한계에 적는다.
- 10/16에 다시 검토했다. 가까운 곳의 낮은 물체를 보려고 θ를 크게 하거나 3×2로 되돌리는 안을 비교했다. 그 결과 1×3과 θ = 12°를 유지했다 (아래 3번).
- 따라서 진동 모듈은 6개 주문했다 (3개 사용 + 여분 3). 센서 6개 중 3개는 예비다.

**2. 좌우 벌림 각도 ±27° → ±25° (출발점)**
- 사각지대가 닫히는 거리 = s ÷ (tan 13.5° − tan(φ − 13.5°))
- φ = 27°는 분모가 0이 되어 사각지대가 닫히지 않는다. φ = 25°, s ≈ 22 mm이면 약 60 cm에서 닫힌다. 1 m 앞 겹침은 약 2%다.
- 0° 쐐기 블록을 추가한다 (10/12). 같은 마운트로 평행 배치 실험(문제 발견)을 할 수 있다.

**3. 세로 기울기 0° → 아래로 12° (출발점, 힌지 0~15°로 실험)**
- θ = 12°일 때 시야가 덮는 높이:

| 앞쪽 거리 | 0.5 m | 1.0 m | 2.0 m |
|---|---|---|---|
| 덮는 높이 | 1.50~1.75 m | 1.26~1.77 m | 0.79~1.79 m |

- θ가 작으면 시야 위쪽이 정수리보다 높은 곳(부딪힐 일 없는 곳)에 낭비되고, 가까운 곳의 낮은 물체를 덜 본다.
- θ가 반각 13.5°를 넘으면 시야 위 끝이 수평 아래로 내려가 가까운 이마 높이 물체를 놓친다.
- 그래서 위 끝이 거의 수평인 12~13°가 한 줄로 할 때 가장 좋다. 12°와 13°의 차이(아래쪽 1~2 cm)는 걸을 때 고개 흔들림보다 작으므로 최종값은 실험으로 정한다.
- 남는 정수리 띠(센서보다 위 6 cm, x₀ = 229 cm)는 각도 대신 센서 줄을 머리에서 최대한 높게 달아 줄인다.

**4. 경고 시작 거리 1.5 m → 2 m (단계 2.0 / 1.0 / 0.5 m)**
- 2 m 앞에서는 지팡이 사각지대 대부분(0.79~1.79 m)을 덮는다. 멀리서 일찍 알리는 것을 택했다.
- 확인할 것: 밝은 곳에서 2 m가 재지는지, 좁은 복도에서 좌우 모터가 계속 울리지 않는지.

**5. MPU-6050으로 고개 각도 측정 추가**
- 이유: 걸을 때 고개가 끄덕이고 헤드 스트랩이 미끄러져 센서 각도가 바뀐다. 경고 거리 2 m에서는 고개를 숙이면 바닥이 경고 범위에 들어온다 (예상과 달랐던 점 5).
- 방법: 상보 필터(α 출발점 0.98)로 고개 각도 p를 재고, 예상 바닥 거리 H ÷ sin(θ + p + 13.5°) 근처의 측정값은 바닥으로 보고 진동하지 않는다.
- 한계: 각도를 알 뿐 시야를 고정하지는 못한다.

**6. 낭떠러지(내려가는 턱) 경고는 하지 않는다**
- 이유: 흰 지팡이가 가장 잘 찾는 것이다. 이 장치는 지팡이가 못 잡는 것을 보완한다.

**7. 사라진 물체 경고 유지 (TTC)**
- 이유: 한 줄 시야라서 낮은 물체는 가까워지면 시야에서 빠진다 (θ = 12°일 때 가슴 높이 1.3 m는 0.92 m, 허리 높이 1.0 m는 1.55 m부터 놓친다). 진동이 멈추면 "앞이 비었다"고 오해한다.
- 방법: 접근 속도로 충돌까지 남은 시간(TTC)을 계산해 그동안 진동을 유지한다. Δt는 미적분 접근 실험으로 정한다.

**8. 머리 고정: 고프로 호환 헤드 스트랩, 세로 각도는 고프로 마운트로 조절**
- 이유: 위쪽 끈(탑 스트랩)이 앞이 무거운 센서 유닛이 처지는 것을 막는다. 이마 쪽 고프로 마운트가 나사로 조이는 힌지라서, 센서 바에 M3 힌지를 따로 설계하지 않아도 된다.
- 정품(약 3만 원대) 대신 호환품을 고른다. v1 시제품이고, 끈이 미끄러지는지는 MPU-6050으로 확인할 수 있다.
- 나사는 고프로 구멍(약 5 mm)에 맞는 M5를 쓴다. M3는 헐거워서 각도가 틀어진다.

### 다음에 할 일
- 고프로 호환 헤드 스트랩, M2·M3 볼트, M5 나비볼트 주문
- 핀헤더 납땜 → `00_i2c_scan`으로 센서 6개 점검, 3개 고르기, MPU-6050 확인
- 센서 칩 중심 위치·기판 두께·뒷면 부품 높이·핀헤더 방향 실측 → 센서 홀더 시험 출력
- 쐐기 블록 0°, 25° 출력
