danny50167/Space-to-Touch/docs/parts.md

# 준비물 목록

✅ = 이미 있음. **필요한 단계** 열(`docs/roadmap.md`의 단계)을 보고 앞 단계에 필요한 것부터 주문한다.
부품은 **국내 쇼핑몰**(1~3일 배송)에서 산다. 해외 배송은 2~3주가 걸려 작업이 멈춘다.

---

## 주문 목록 (11/11 확정)

**11/13 주문함.** 실제 구매 내역은 `docs/purchases-2026-11.xlsx`에 있다 (디바이스마트 46,216원, 쿠팡 21,310원). 아래 목록과 다른 점: 진동 모듈 4개(목록 6), 케이블·만능기판·전선·열수축 튜브는 가진 것을 쓴다, M3 와셔 20개 추가. 아직 안 산 것은 엑셀의 두 번째 시트에 있다.

배송비를 줄이려고 **두 곳**에서만 산다. 링크와 체크 칸이 있는 주문표: https://claude.ai/artifact/5PVkkeJJqAPPEhkiUpkK5h (사용자 소유, 비공개)

- **디바이스마트 한 번 주문**: 66,000원(VAT 포함) 이상이면 무료배송, 아니면 2,700원. 이번 주문은 약 7만 4천 원이라 무료다.
- **쿠팡 로켓배송**: 와우 회원이라 무료. 디바이스마트에 없거나 쿠팡이 나은 것(헤드 스트랩, 캘리퍼스, 기구 소모품)만 산다.
- 가격은 11/11 판매 페이지의 VAT 포함 가격이다. 쿠팡은 작업 환경에서 페이지가 열리지 않아 검색 링크와 고르는 기준만 적었다.

### 디바이스마트
| 상품 | 수량 | 단가 | 왜 / 무엇에 |
|---|---|---|---|
| [ESP32 DevKitC WROOM-32D V4 CP2102 [CMODULE-40]](https://www.devicemart.co.kr/goods/view?no=15313999) | 2 | 9,900 | 주 보드 + 예비. 38핀, 마이크로 USB, CP2102 |
| [ESP32 DevKitC V4 확장보드 터미널 쉴드 [CMODULE-47]](https://www.devicemart.co.kr/goods/view?no=15315957) | 1 | 4,400 (할인가) | 핀마다 G·V·S, V 전압 점퍼. 진동 모듈을 바로 꽂는다 (`wiring.md` 0장) |
| [아두이노 진동모터 모듈 [ELB060416]](https://www.devicemart.co.kr/goods/view?no=1312092) | 6 | 3,300 | 3개 사용 + 여분 3 |
| [74HCT125N (DIP)](https://www.devicemart.co.kr/goods/view?no=1057573) | 1 | 660 | 대비책: 3.3V 신호가 약할 때 5V 신호로 바꾼다 |
| [E/C 25V 100uF (105℃)](https://www.devicemart.co.kr/goods/view?no=29527) | 10 | 44 | 모터 전원 잡음 줄이기 (10개 단위) |
| [소켓 점퍼 케이블 40P (F/F) 30cm](https://www.devicemart.co.kr/goods/view?no=32284) | 1 | 1,100 | 진동 모듈 ↔ 확장보드 |
| [소켓 점퍼 케이블 40P (F/F) 20cm](https://www.devicemart.co.kr/goods/view?no=1321192) | 1 | 935 | 센서·멀티플렉서·MPU-6050 ↔ 확장보드 |
| UL1007 AWG26 10M [빨강](https://www.devicemart.co.kr/goods/view?no=13003205) · [검정](https://www.devicemart.co.kr/goods/view?no=13003203) · [흰색](https://www.devicemart.co.kr/goods/view?no=13003208) · [파랑](https://www.devicemart.co.kr/goods/view?no=13003207) · [초록](https://www.devicemart.co.kr/goods/view?no=13003206) | 각 1 | 3,300 / 3,300 / 2,640 ×3 | 최종 조립 배선: + / GND / 모듈 IN / SDA / SCL |
| [NT- DIY 열수축튜브 328세트](https://www.devicemart.co.kr/goods/view?no=1320936) | 1 | 4,290 | 전선 연결부 보호 |
| [[GA6] 50 × 80 사각 만능 기판 (양면)](https://www.devicemart.co.kr/goods/view?no=24860) | 1 | 3,850 | 머리 유닛 배선판 |
| [핀헤더소켓 Single 1×40 Straight](https://www.devicemart.co.kr/goods/view?no=3585) | 2 | 583 | 만능기판에 멀티플렉서를 끼울 소켓 |
| 스텐 둥근머리 샘스볼트 [M3x10](https://www.devicemart.co.kr/goods/view?no=10911633) | 10 | 44 | 진동 모듈 3개 × 2 + GY-521 × 2 + 여분. 십자 머리, 와셔 2장이 붙어 있다 |
| 스텐 둥근머리 샘스볼트 [M3x16](https://www.devicemart.co.kr/goods/view?no=10911636) · [M3x20](https://www.devicemart.co.kr/goods/view?no=10911637) · [M3x25](https://www.devicemart.co.kr/goods/view?no=10911638) | 각 5 | 55 / 55 / 66 | 쐐기 블록 고정. 쐐기 각도마다 두께가 달라서 길이 3가지 |
| [너트 (니켈) M3](https://www.devicemart.co.kr/goods/view?no=34324) | 25 | 11 | M3 볼트용 |
| 스텐 유두머리 렌치볼트 [M2x8](https://www.devicemart.co.kr/goods/view?no=10915158) · [M2x10](https://www.devicemart.co.kr/goods/view?no=10915159) · [M2x12](https://www.devicemart.co.kr/goods/view?no=10915160) | 각 10 | 55 | 센서 고정. 홀더 두께가 정해지기 전이라 길이 3가지 |
| [너트 (니켈) M2](https://www.devicemart.co.kr/goods/view?no=34323) | 30 | 11 | M2 볼트용 |

### 쿠팡 (로켓배송 표시가 있는 상품만)
| 무엇 | 수량 | 고르는 기준 |
|---|---|---|
| [고프로 호환 헤드 스트랩](https://www.coupang.com/vp/products/1800447723?itemId=3063437232&vendorItemId=71051392279) | 1 | 로켓배송인지, 탑 스트랩·이마 3발 마운트·나비나사가 있는지 담기 전에 확인 |
| [고프로 나비나사 세트](https://www.coupang.com/np/search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) | 1 | M5, 짧은 것과 긴 것(약 25 mm 이상)이 함께 든 세트 |
| [디지털 캘리퍼스 150 mm](https://www.coupang.com/np/search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) | 1 | 스테인리스, 분해능 0.01 mm (플라스틱 몸체는 피한다) |
| [육각렌치 세트](https://www.coupang.com/np/search?q=%EC%9C%A1%EA%B0%81%EB%A0%8C%EC%B9%98+%EC%84%B8%ED%8A%B8+1.5mm) | 1 | **1.5 mm**(M2 유두머리 볼트)가 들어 있는 것. M3는 십자 드라이버로 조인다. 집에 있으면 뺀다 |
| [벨크로 고무 밴드](https://www.coupang.com/np/search?q=%EB%B2%A8%ED%81%AC%EB%A1%9C+%EA%B3%A0%EB%AC%B4%EB%B0%B4%EB%93%9C+50mm) | 1 | 폭 5 cm 안팎, 1 m 이상, 잘 늘어나는 것 |
| [USB-C ↔ 마이크로 5핀 **데이터** 케이블 (1 m 안팎)](https://www.coupang.com/np/search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) | 1 | 맥북 ↔ ESP32 업로드용. 상품명이나 설명에 **"데이터 전송"**(USB 2.0, 480Mbps)이 적힌 것만 고른다. "충전 전용"·"고속 충전"만 적힌 것은 피한다. 단자가 "USB 3.0 Micro-B"(넓은 단자)면 안 맞는다. 학생 집의 나노 케이블은 Mini-USB라서 안 맞는다 |

### 고르면서 뺀 것과 이유
- **DFRobot DFR0440 진동 모듈**: 3.3V 신호가 명시되어 있지만, 사진상 모터가 코인형이 아니고 고정 구멍이 한쪽에만 있다. 설계 문서의 코인 모터 기준과 다르다.
- **ESP32 CH9102X 보드**: 1,100원 싸지만 CP2102가 맥에서 자료가 더 많다.
- **디지털 캘리퍼스 (디바이스마트 MC500-150)**: 업체 직배송이라 배송비 4,400원이 따로 붙는다 → 쿠팡.
- **Coms C ↔ 마이크로 케이블 (IF001)**: 11/11 품절. 디바이스마트의 다른 C ↔ 마이크로 케이블은 데이터 전송 여부를 페이지에서 확인할 수 없어서, 설명을 직접 보고 고를 수 있는 쿠팡으로 옮겼다.
- **USB 브레이크아웃 보드, 모터용 보조배터리 분리**: 확장보드로 전원을 한 곳에서 넣기로 해서 뺐다 (`wiring.md` 3장).
- **M2·M3·M4 볼트 키트 480pcs (LS026, 30,800원)**: 처음에 골랐지만 M4는 쓸 곳이 없고 양이 많다. 필요한 만큼 낱개로 바꿨다 (11/11). M3는 약 14개(진동 모듈 6, GY-521 2, 쐐기 블록 약 6)만 쓴다. M3 키트(340pcs, 9,680원)도 같은 이유로 뺐다.
- **M2 황동 서포트 키트**: 준비 기간이 1주일이라 디바이스마트 주문 전체가 늦어질 수 있다. 스페이서는 PLA로 출력한다.

---

## 0. 가진 부품 점검 (가장 먼저)

주문하기 전에 가진 부품부터 확인한다. 불량을 늦게 발견하면 교체품을 기다리느라 일정이 밀린다.
점검 결과는 맨 아래 **점검 기록표**에 적고, 같은 내용을 설계 일지에도 남긴다.

### VL53L1X 모듈 ×6 (3개 사용, 3개 예비)
- [ ] 판매 페이지에서 **모델명**을 확인한다. 이름이 비슷한 **VL53L0X**(최대 약 2 m, 라이브러리가 다름)와 헷갈리기 쉽다.
- [x] 입력 전압: **5 V 호환 확인** (10/11). 레벨 변환 모듈은 필요 없다.
- [ ] ESP32로 바꿨으므로(11/10) 센서 VIN은 **ESP32 3.3V**에 연결한다. 3.3V에서도 6개 모두 잡히는지 `00_i2c_scan`으로 확인한다.
- [ ] 센서 창에 붙은 **보호 필름**(노란색 또는 투명)을 뗀다. 붙어 있으면 필름에 반사된 빛 때문에 거리가 짧게 나온다.
- [ ] 핀헤더가 납땜되어 있는지 확인한다. 핀을 구멍에 꽂기만 하면 접촉이 불안정해서 측정이 끊긴다 → **납땜이 먼저**다.
- [ ] `firmware/00_i2c_scan`으로 **6개를 모두** 검사한다 (주소 0x29, "VL53L1X 확인"이 떠야 한다).
  장치에는 3개만 쓴다 (1×3, 10/12 변경). 6개를 모두 확인해 두면 나머지 3개를 믿을 수 있는 예비로 쓸 수 있다.

### TCA9548A 멀티플렉서
- [ ] A0·A1·A2가 GND에 연결되어 있는지 확인한다 (주소 0x70).
- [ ] 핀헤더 납땜
- [ ] `00_i2c_scan`에서 "0x70 TCA9548A"가 보이는지 확인한다 (센서 연결 전에도 확인 가능).

### ESP32 DevKitC (11/10 결정, 11/11 상품 확정, 주문 전)
- [ ] 맥북과 연결할 **데이터용** USB-C ↔ 마이크로 USB 케이블을 준비한다 (주문 목록에 있다). 충전 전용 케이블이면 포트가 보이지 않는다.
- [ ] 보드의 USB 칩 이름(CP2102로 주문)을 기록한다. 맥에서 포트가 안 보이면 Silicon Labs CP210x 드라이버를 설치한다.
- [ ] 확장보드의 V 전압 점퍼를 **5V**에 끼운다 (`docs/wiring.md` 0장).
- [ ] `docs/esp32.md` 순서대로 Blink 업로드 → 무선 기록을 맥북 터미널로 받아 본다.

### Arduino Mega, Uno (예비)
- [ ] 예제 Blink 업로드 → 보드가 살아 있는지만 확인한다. ESP32가 고장 나면 대신 쓴다 (펌웨어는 그대로 돌아간다).

### 진동 모터 → 모듈로 교체 (10/12 결정)
처음 산 코인 모터는 리드선이 너무 가늘어 피복을 벗기거나 납땜하기 어려웠다.
→ **구동 회로(MOSFET)가 내장된 진동 모터 모듈**로 바꾼다. 납땜이 필요 없고, 트랜지스터 구동 회로를 직접 만들 필요도 없어진다.
(이 과정도 설계 일지에 "부품 선정 시행착오"로 남긴다.)

- **아직 주문하지 않았다** (11/10 확인. 그전 문서에는 '주문 완료'로 잘못 적혀 있었다).
- **고른 것 (11/11): 디바이스마트 [ELB060416](https://www.devicemart.co.kr/goods/view?no=1312092) (YwRobot) 6개** (3개 사용 + 여분 3).
- 판매 페이지에서 확인한 사양:
  - 크기 24.5 × 21 mm, 고정 구멍 3 mm, 구멍 간격 15 mm
  - 전압 5V (판매자 답변: 5V를 유지해야 한다, 6V 이상은 오래 쓰면 불량), 정격 전류 최대 60 mA, 기동 전류 최대 90 mA
  - 모터: 지름 10 mm, 두께 2.7 mm 코인형. MOS 구동, IN이 HIGH면 켜지고 LOW면 꺼진다. PWM으로 세기 조절
  - 핀 순서 GND · VCC · IN (직각 핀헤더가 납땜되어 있다)
- **3.3V 신호 근거:** 구매 후기 "라즈베리파이 GPIO에 연결하여 잘 사용중"(라즈베리파이 핀도 3.3V). 그러나 "3.3V로는 안 되나요?"라는 문의에 판매자가 "5V로 연결해야 사용 가능"이라고 답했다. 전원 질문인지 신호 질문인지 분명하지 않다. → 대비책으로 **74HCT125N**(3.3V → 5V 신호)을 같이 산다 (`docs/wiring.md` 2장).

도착하면:
- [ ] 판매 페이지와 모터에서 **정격 전압, 정격 전류, 회전수(rpm)** 를 찾아 기록한다.
  - 회전수로 **예상 진동수 = rpm ÷ 60** 을 계산해 둔다 (물리 탐구의 비교 기준).
- [ ] 기판을 보고 **MOSFET과 다이오드**를 찾아 회로도를 직접 그린다 (`docs/wiring.md` 2장).
- [ ] 장착 구멍 지름과 구멍 사이 간격을 캘리퍼스나 자로 잰다 → PLA 모터 홀더 설계에 쓴다.
- [ ] `03_motor_localization_test`의 `1`~`3` 명령으로 6개를 모두 돌려 본다. 모터 0~2 자리에 바꿔 꽂으며 확인한다 (배선은 `docs/wiring.md` 2장).
- 기존 코인 모터는 버리지 않는다. 인두로 선 끝을 달궈 납이 묻으면 물리 실험용 예비로 쓸 수 있다.

### 스마트폰 (phyphox)
- [ ] phyphox를 설치하고, 가속도 센서의 **측정률(Hz)** 을 확인한다.
  - 진동수를 제대로 재려면 측정률이 **예상 진동수의 2배 이상**이어야 한다 (표본화 정리).
  - 측정률이 부족하면 측정 방법을 바꿔야 한다 (예: 마이크로 모터 소리를 분석하는 오디오 스펙트럼). 이것도 물리 탐구에서 다룰 수 있는 "문제 발견"이다.

---

## 1. 전자 부품

| 부품 | 수량 | 필요한 단계 | 용도 / 비고 |
|---|---|---|---|
| ✅ VL53L1X 모듈 | 6 | — | 위 점검 목록 참고 |
| ✅ TCA9548A 멀티플렉서 | 1 | — | |
| ESP32 DevKitC WROOM-32D V4 CP2102 + 확장보드 | 2 + 1 | **부품 준비** | 주 보드. 무선 기록 (`docs/esp32.md`). 위 "주문 목록" |
| USB-C ↔ 마이크로 USB 데이터 케이블 | 1 | **부품 준비** | 맥북과 보조배터리(USB-C 단자 있음)에 같이 쓴다. 위 "주문 목록" |
| ✅ Arduino Mega, Uno | 각 1 | — | 예비 보드 |
| ✅ MPU-6050 (가속도 + 자이로) | 1 | — | 고개 각도 측정 (`docs/wiring.md` 4장) |
| 진동 모터 모듈 ELB060416 + 대비책 74HCT125N | 6 + 1 | **부품 준비** | 위 '진동 모터 → 모듈로 교체' 참고. 처음 산 코인 모터는 리드선 문제로 교체 |
| 핀헤더 + 납땜 장비 | 1세트 | **센서 1개** | 센서와 멀티플렉서에 핀헤더 납땜. 동아리실 장비가 있는지 먼저 확인 |
| 점퍼선 (수–수, 수–암, **암–암**) | 넉넉히 | **센서 1개** | 핀헤더끼리 연결할 때는 암–암이 필요하다 |
| 브레드보드 | 1~2 | 센서 1개 | 시험용 |
| 멀티미터 | 1 | 센서 1개 | 전압, 끊어진 선, 배선 확인. 동아리실 것이 있으면 생략 |
| 전해 커패시터 100µF 25V | 10 | 진동 모터 | 모터 전원 안정화 |
| ✅ 5V 보조배터리 | 1 | 진동 모터 | ESP32(와 모터) 전원. ⚠️ 아래 "보조배터리 주의"와 `docs/wiring.md` 3장 참고 |
| 암–암 점퍼선 30 cm, 20 cm (40가닥 묶음) | 각 1 | 진동 모터 | 모듈 ↔ 확장보드는 수 핀끼리라 **암–암**. 착용 위치가 정해지면 필요한 길이로 바꾼다 |
| UL1007 AWG26 전선 5색 (각 10 m) | 5 | 통합 | 최종 조립: 몸 유닛 ↔ 모듈 3심(+, GND, IN), 머리 유닛 ↔ ESP32 4심(3.3V, GND, SDA, SCL). 꼬아서 쓴다 |
| 열수축 튜브 세트 | 1 | 통합 | 전선 연결부 보호 |
| 만능기판 50 × 80 + 핀헤더 소켓 | 1 + 2 | 통합 | 머리 유닛 배선판 (브레드보드는 착용 중 빠진다) |

**보조배터리 주의:** 보조배터리는 흐르는 전류가 작으면 스스로 꺼지는 제품이 많다. 진동이 짧게 끊어지는 패턴(80 ms 켜짐)에서는 평균 전류가 작아 꺼질 수 있다.
- 살 때: "저전류 모드" 또는 "항상 켜짐" 기능이 있는지 확인한다.
- 진동 모터 단계에서 확인: 모터 1개를 1단계 패턴(80 ms / 700 ms)으로 2분 이상 돌려서 배터리가 꺼지지 않는지 본다.

### 조건부 주문
| 부품 | 언제 | 비고 |
|---|---|---|
| VL53L1X 모듈 추가 | 점검에서 정상인 것이 3개 미만이거나 VL53L0X였을 때 | 같은 판매처 제품으로 통일한다 |

## 2. 기구 부품

| 부품 | 수량 | 필요한 단계 | 용도 / 비고 |
|---|---|---|---|
| ✅ PLA 3D 프린터 | — | — | |
| PLA 필라멘트 | 남은 양 확인 | 기구 설계 | v1, v2, 모터 홀더, 쐐기 블록 여러 개를 출력한다. 1 kg 한 롤 기준 절반 이상 남아 있으면 충분 |
| M3 샘스볼트(와셔 일체) 10 mm 10개 + 16·20·25 mm 각 5개 + M3 너트 25 + M2 볼트 8/10/12 mm 각 10 + M2 너트 30 + 육각렌치 1.5 mm | 1 | 기구 설계 | 센서 M2(구멍 2 mm), 진동 모듈·GY-521 M3(구멍 3 mm), 쐐기 블록 M3 12~16 mm |
| 고프로 나비나사 세트 (M5, 짧은 것 + 긴 것) | 1 | 기구 설계 | 고프로 마운트 힌지(세로 각도). 마운트 총두께를 재고 길이를 고른다 |
| 고프로 호환 헤드 스트랩 (탑 스트랩, 실리콘 미끄럼 방지, 3발 마운트) | 1 | 기구 설계 | 헤드 마운트를 고정한다. 이마 쪽 마운트를 세로 각도 힌지로 쓴다. [쿠팡](https://www.coupang.com/vp/products/1800447723?itemId=3063437232&vendorItemId=71051392279) |
| 디지털 캘리퍼스 150 mm | 1 | 기구 설계 | 스트랩 마운트, 모듈·센서 구멍, 기판 두께 실측 (없어서 산다) |
| 고무 밴드(웨빙, 폭 3~5 cm) + 벨크로 | 1 m | 기구 설계 | 진동 밴드 |
| 집에 있는 부드러운 재료 (주방 스펀지, 포장용 폼, 마우스패드, 폼 양면테이프) | 조금 | 진동 모터 | 모터 진동 격리와 ⭐물리 실험(있음/없음 비교). 사지 않는다 (11/12). 재료를 2~3가지로 바꿔 비교해도 된다 |
| 글루건 | 1 | 센서 1개 | 임시 고정 |

## 3. 실험 도구

| 도구 | 필요한 단계 | 용도 |
|---|---|---|
| 줄자, 각도기 | 센서 1개 | 거리 정확도, 센서 각도 검증 |
| 흰 판지, 검은 천 | 센서 1개 | 측정 표적 (표면 재질 비교) |
| 맥북 + 데이터 저장 방법 | 부품 준비 | 책상 실험은 시리얼 모니터(USB), 걸으면서 하는 실험은 무선 기록을 터미널에서 파일로 저장한다 (`docs/esp32.md`). 부품 점검 때 미리 연습한다 |
| 스마트폰 + phyphox 앱 (무료) | 진동 모터 | ⭐ 진동수, 진동 전달 측정 (위 "측정률" 확인 먼저) |
| 컴퍼스 + 자 | 진동 모터 | ⭐ 두 점 역치. 바늘 끝이 피부를 찌르지 않도록 끝을 무디게 하거나 덮는다 |
| 안대, 이어폰 (백색소음) | 진동 모터 | 사용자 실험 |
| 종이 상자, 풍선 | 사용자 실험 | 부딪혀도 안전한 장애물 |
| 스톱워치 | 사용자 실험 | 통과 시간 측정 |

---

## 점검 기록표

학생이 직접 채운다. 판매 페이지 링크도 함께 남긴다 (보고서의 "부품 선정 근거"가 된다).

| 항목 | 확인 내용 | 결과 |
|---|---|---|
| VL53L1X 판매 페이지 | 모델명 / 입력 전압 | 입력 전압: 5 V 호환 |
| VL53L1X 0~5번 | `00_i2c_scan` 결과 (O / X) | 0: 1: 2: 3: 4: 5: |
| TCA9548A | 주소 0x70 확인 | |
| ESP32 | USB 칩 이름 / Blink 업로드 / 무선 기록 수신 | |
| Arduino Mega / Uno (예비) | Blink 업로드 | |
| 진동 모터 모듈 판매 페이지 | 모델명 / 제어 신호 3.3V 가능 여부 | |
| 진동 모터 모듈 사양 | 정격 전압 / 정격 전류 / rpm → 예상 진동수 | |
| 진동 모터 모듈 IN 신호 | 3.3V일 때와 5V일 때 세기 비교 | |
| 진동 모터 모듈 1~6번 | `03`의 `1`~`3` 명령으로 회전 확인 | |
| 모듈 장착 구멍 | 지름 / 구멍 간격 | |
| 스마트폰 가속도 센서 | phyphox 측정률 (Hz) | |
| 보조배터리 | 저전류 모드 여부 | |
