danny50167/Space-to-Touch/docs/purchases-2026-11.xlsx

Sheet: 구매 내역
구매처 | 품목 | 수량 | 단가 (VAT 포함) | 금액 | 용도 | 비고
디바이스마트 | ESP32 DevKitC WROOM-32D V4 CP2102 개발보드 | 2 | 9900원 |  | 주 보드 + 예비
디바이스마트 | ESP32 DevKitC V4 확장보드 터미널 쉴드 | 1 | 4400원 |  | 진동 모듈·센서 연결 | V 점퍼를 5V에
디바이스마트 | 아두이노 진동모터 모듈 ELB060416 | 4 | 3300원 |  | 진동 모터 3 + 여분 1 | 목록은 6개였음
디바이스마트 | 74HCT125N (DIP) | 1 | 660원 |  | 3.3V 신호가 약할 때 대비책
디바이스마트 | E/C 25V 100uF (105℃) 6.3×11 | 10 | 44원 |  | 모터 전원 잡음 줄이기
디바이스마트 | 핀헤더소켓 Single 1×40 Straight (2.54mm) | 2 | 583원 |  | 만능기판에 멀티플렉서 꽂기
디바이스마트 | 스텐 평와샤 M3 | 20 | 11원 |  | 여분 | 샘스볼트에 와셔가 있어 꼭 필요하진 않음
디바이스마트 | 스텐 유두머리 렌치볼트 M2x8 | 10 | 55원 |  | 센서 고정 | 육각렌치 1.5 mm
디바이스마트 | 스텐 유두머리 렌치볼트 M2x10 | 10 | 55원 |  | 센서 고정
디바이스마트 | 스텐 유두머리 렌치볼트 M2x12 | 10 | 55원 |  | 센서 고정
디바이스마트 | 너트 (니켈) M2 | 30 | 11원 |  | M2 볼트용
디바이스마트 | 스텐 둥근머리 샘스볼트 M3x10 | 10 | 44원 |  | 진동 모듈·MPU-6050 고정 | 십자, 와셔 일체
디바이스마트 | 스텐 둥근머리 샘스볼트 M3x16 | 5 | 55원 |  | 쐐기 블록 고정
디바이스마트 | 스텐 둥근머리 샘스볼트 M3x20 | 5 | 55원 |  | 쐐기 블록 고정
디바이스마트 | 스텐 둥근머리 샘스볼트 M3x25 | 5 | 66원 |  | 쐐기 블록 고정
디바이스마트 | 너트 (니켈) M3 | 30 | 11원 |  | M3 볼트용
디바이스마트 | 배송비 | 1 | 2700원 |  |  | 66,000원 미만이라 유료
쿠팡 (로켓) | 에스엠제이 고프로 HERO SJ캠 헤드 스트랩 | 1 | 5500원 |  | 센서 바를 머리에 고정 | 나비나사 들었는지 도착 후 확인
쿠팡 (로켓) | 물건이지 쫀쫀한 고탄력 광폭 밴드 | 1 | 9300원 |  | 진동 모듈 착용 밴드
쿠팡 (로켓) | 탐사 디지털 캘리퍼 정밀자 | 1 | 6510원 |  | 부품 실측 | 플라스틱 몸체: 두세 번 재서 평균
쿠팡 (로켓) | 배송비 | 1 | 0원 |  |  | 와우 로켓배송
 | 디바이스마트 합계 |  |  |  |  | 견적서 총액 46,216원
 | 쿠팡 합계
 | 총합계

Sheet: 아직 안 산 것
품목 | 꼭 필요한가 | 언제 필요 | 고를 때 확인
USB-A ↔ 마이크로 5핀 케이블 + USB 허브 | 사지 않음 (가진 것) | ESP32 업로드 | 그 케이블로 휴대폰 사진 옮기기 등 데이터를 주고받은 적이 있으면 OK. 맥북이 ESP32를 못 찾으면 케이블부터 바꿔 본다
육각렌치 1.5 mm | 집에 없으면 필수 | 센서 고정 (M2 볼트) | 1.5 mm가 들어 있는 세트
고프로 나비나사 (M5, 긴 것 포함) | 스트랩에 없으면 | 헤드 마운트 각도 조절 | 스트랩 도착 후 구성품 확인하고 결정
암–암 점퍼선 20 cm 이상 9가닥 | 가진 것에 없으면 | 진동 모듈 ↔ 확장보드 | 가진 점퍼선 중 암–암이 있는지 확인
진동 모듈 ELB060416 2개 추가 | 선택 | 여분 | 목록은 6개, 주문은 4개. 고장이 잦으면 추가
