danny50167/Space-to-Touch/cad/reference/vl53l1x_fov_cone_60mm.step

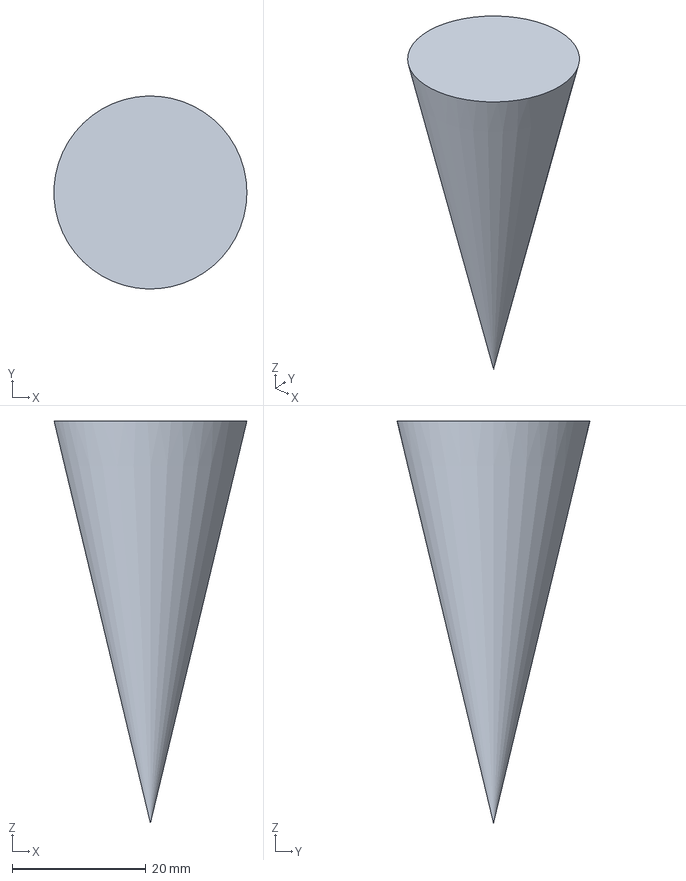
[picture p1: CAD file, 2026-10-19]
cad/reference/vl53l1x_fov_cone_60mm.step
28.8 x 28.8 x 60.0 mm
