danny50167/Space-to-Touch/cad/reference/gy521_mpu6050_ref.step

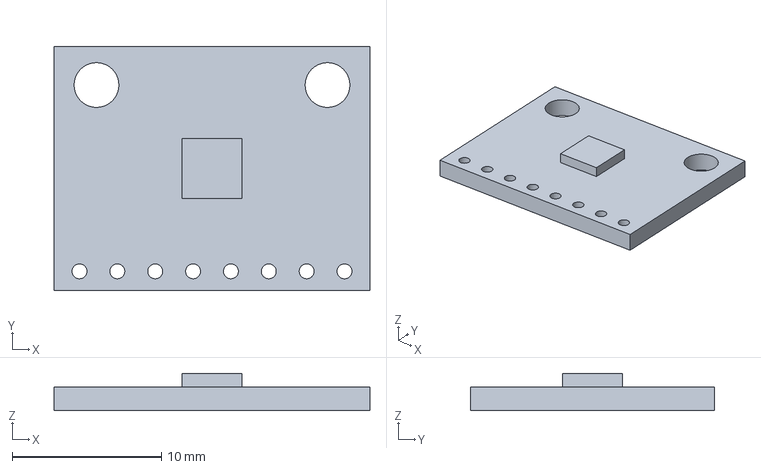
[picture p2: CAD file, 2026-10-19]
cad/reference/gy521_mpu6050_ref.step
21.2 x 16.4 x 2.50 mm
