danny50167/Space-to-Touch/cad/reference/vl53l1x_module_ref.step

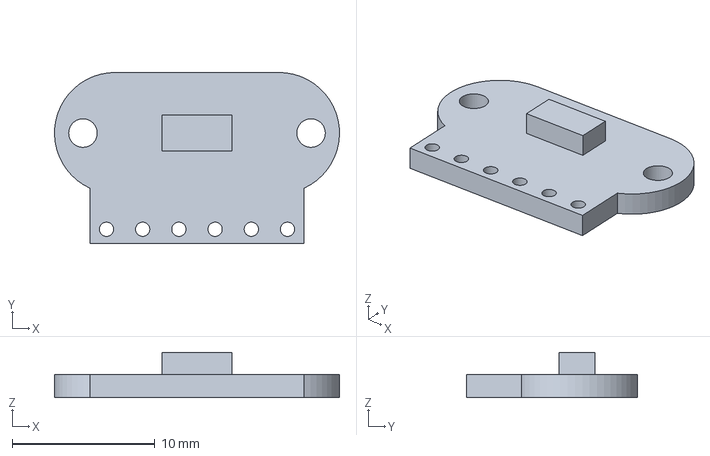
[picture p3: CAD file, 2026-10-19]
cad/reference/vl53l1x_module_ref.step
20.0 x 12.0 x 3.16 mm
