danny50167/Space-to-Touch/docs/wiring.md

# 배선

보드는 **ESP32 DevKitC**를 쓴다 (11/10 결정, 이유는 `docs/esp32.md`). Mega·Uno는 예비로 두고, 펌웨어는 세 보드 모두에서 돌아간다.

## 0. 확장보드 (터미널 쉴드)에 ESP32 꽂기

ESP32 DevKitC는 폭이 넓어서 브레드보드에 꽂으면 한쪽 핀을 거의 못 쓴다. 그래서 **확장보드(CMODULE-47)** 에 꽂아 쓴다 (11/11 결정).

- 확장보드의 노란 소켓 두 줄 중 ESP32 핀 간격에 맞는 쪽(25.5 mm 또는 24.0 mm)에 꽂는다. **USB 단자 방향**을 기판 그림과 맞춘다.
- ESP32 핀마다 **G · V · S** 3핀이 나와 있다. S = 그 핀의 신호, V = 전원, G = GND다.
- **V 전압 점퍼(JUMP)** 를 **5V** 쪽에 끼운다. 진동 모듈이 V에서 5V를 받는다.
  - ⚠️ 그래서 V 핀은 **5V**다. I2C 부품(센서, 멀티플렉서, MPU-6050)의 전원은 V 핀이 아니라 **3V 전원 핀(또는 ESP32 3V3 핀의 S)** 에서 받는다.
  - GPIO 21·22의 3핀 중에서는 **S만** 쓴다 (SDA, SCL). 같은 줄의 V에 센서 전원을 꽂으면 SDA·SCL에 5V가 걸릴 수 있다.

### 전원은 한 곳에서만 넣는다 ⚠️
- ESP32의 **마이크로 USB 하나로만** 전원을 넣는다. 책상에서는 맥북, 걸을 때는 보조배터리다.
- 그 상태에서 확장보드의 USB-C·마이크로 USB·DC 잭에 **다른 전원을 같이 꽂지 않는다.** ESP32 제조사(Espressif)는 전원 넣는 방법 3가지(USB, 5V 핀, 3V3 핀) 중 **하나만** 쓰라고 하고, 둘 이상이면 보드나 전원이 망가질 수 있다고 경고한다.

## 1. I2C (센서 3개 + 멀티플렉서)

| TCA9548A | ESP32 | Mega (예비) | Uno (예비) |
|---|---|---|---|
| VIN | **3.3V** | 5V | 5V |
| GND | GND | GND | GND |
| SDA | GPIO 21 | 20 (SDA) | A4 |
| SCL | GPIO 22 | 21 (SCL) | A5 |
| A0, A1, A2 | GND → 주소 0x70 | 동일 | 동일 |

- 센서 i의 SDA/SCL → TCA9548A의 **SDi / SCi** (i = 0~2, README의 번호 규칙과 같음)
- 센서 VIN/GND → 멀티플렉서와 같은 전원(ESP32는 3.3V)/GND
- ⚠️ **ESP32 핀은 3.3V까지만 견딘다.** I2C 부품(센서, 멀티플렉서, MPU-6050)은 모두 ESP32의 **3.3V 핀**에 연결한다.
  5V에 연결하면 모듈의 풀업 저항을 통해 SDA·SCL에 5V가 걸릴 수 있다.
  - 센서는 5V 호환을 확인했지만(10/11), 3.3V에서 되는지는 `00_i2c_scan`으로 6개 모두 다시 확인한다.
- 센서 바(센서 + 멀티플렉서 + MPU-6050)와 뒤통수의 ESP32 사이는 **4선(3.3V, GND, SDA, SCL) 한 묶음**으로 연결한다 (배치는 `design-notes.md` 4-7, 11/13).
  - I2C는 선이 길면(1 m 이상) 불안정할 수 있다. 그래서 ESP32를 몸이 아니라 머리 뒤에 두어 이 선을 30~40 cm로 짧게 한다. I2C 속도는 기본값 100 kHz를 쓴다.
  - 멀티플렉서는 센서 바에 둔다. 그러면 머리를 도는 선이 센서 3개분(12가닥)이 아니라 4가닥이다.

## 2. 진동 모터 모듈 (MOSFET 구동 회로 내장)

보드 핀은 약 20~40 mA까지만 낼 수 있지만, 진동 모터는 **60~100 mA**가 필요하다.
그래서 모터를 핀에 직접 연결하지 않고, **MOSFET(또는 트랜지스터)이 들어 있는 진동 모터 모듈**을 쓴다.
보드 핀은 MOSFET을 켜고 끄는 신호만 보내고, 모터 전류는 5V 전원에서 흐른다.

모듈 핀 순서(GND · VCC · IN)가 확장보드의 G · V · S 순서와 같다. **암–암 점퍼선 3가닥**을 그대로 이어 꽂으면 된다.

| 모듈 핀 | 확장보드 | 뜻 |
|---|---|---|
| GND | G | GND |
| VCC | V (점퍼를 **5V**에) | 모터 전원 5V |
| IN | S | ESP32 PWM 핀 (아래 표) |

- IN이 HIGH면 켜지고 LOW면 꺼진다. PWM(`analogWrite`)으로 켜진 시간의 비율(듀티비)을 바꿔 세기를 조절한다.
- **ESP32의 HIGH는 3.3V다.** 모터 전원(VCC)은 그대로 5V라서 세기는 같지만, 모듈의 스위치가 3.3V 신호로 완전히 켜져야 한다.
  - 고른 모듈(ELB060416)은 라즈베리파이(3.3V 신호) GPIO에 연결해 잘 쓴다는 구매 후기가 있다 (`docs/parts.md`). 그래도 도착하면 직접 확인한다: IN 선을 ESP32 핀에서 빼고 **ESP32 3V3 핀**에 꽂을 때와 **5V 핀**에 꽂을 때 세기를 비교해 일지에 남긴다.
  - 3.3V에서 눈에 띄게 약하면 아래 "대비책: 74HCT125"를 쓴다.
- 확장보드를 쓰면 GND는 저절로 공통이 된다. 따로 전원을 쓸 때는 **GND를 공통으로 묶지 않으면** IN 신호의 기준 전압이 달라져 모터가 제대로 켜지지 않는다.
- 보드가 켜지거나 리셋되는 동안 핀이 잠깐 떠 있어서 모터가 짧게 떨릴 수 있다. 이상한 일은 아니지만 일지에 관찰로 남긴다.

### 모듈 회로 관찰하기 (물리 연계)
모듈 기판에서 MOSFET과 다이오드(있다면)를 찾아 회로도를 직접 그린다. 일반적인 구조는 다음과 같다.

```
         VCC (+5V, 보조배터리)
              │
      ┌───────┤
      │       │
  다이오드    모터
 (띠가 +쪽)    │
      │       │
      └───────┤
              │ D (드레인)
 IN ──────── G   N채널 MOSFET
              │ S (소스)
             GND (ESP32 GND와 공통)
```

- **다이오드**는 모터를 끌 때 코일에 생기는 역기전력으로부터 MOSFET을 보호한다 (전자기 유도 → 물리 연계).
- 기판에 다이오드가 보이지 않으면 그것도 기록한다. 왜 없어도 되는지(또는 문제가 될 수 있는지) 조사해 볼 거리가 된다.

### 대비책: 74HCT125 (3.3V 신호가 약할 때만)
74HCT125는 3.3V 신호를 받아 **5V 신호로 내보내는** 칩이다 (입력 2.0V 이상이면 HIGH로 읽는다). 브레드보드에 꽂아 ESP32와 모듈 사이에 넣는다.

| 74HCT125 핀 | 연결 |
|---|---|
| 14 (VCC) | 5V |
| 7 (GND) | GND |
| 1, 4, 10 (1OE, 2OE, 3OE) | GND (항상 켜 둔다) |
| 2, 5, 9 (1A, 2A, 3A) | ESP32 GPIO 25, 26, 27 |
| 3, 6, 8 (1Y, 2Y, 3Y) | 모듈 0, 1, 2의 IN |
| 12, 13 (4A, 4OE) | GND (안 쓰는 입력은 떠 있지 않게) |

- 핀 번호는 칩의 반달 홈을 위로 두고 왼쪽 위부터 반시계 방향으로 센다. 꽂기 전에 데이터시트 그림으로 한 번 더 확인한다.

| 모터 번호 | ESP32 | Mega (예비) | Uno (예비) |
|---|---|---|---|
| 0 (왼쪽) | GPIO 25 | 2 | 3 |
| 1 (가운데) | GPIO 26 | 3 | 5 |
| 2 (오른쪽) | GPIO 27 | 5 | 6 |

- ESP32 핀 중 0, 2, 5, 12, 15번은 켤 때 보드 동작 모드를 정하는 핀이라 피했다. 25~27번은 Wi-Fi를 켜도 문제없다.

## 3. 전원

| 부하 | 전류 (대략) |
|---|---|
| VL53L1X ×3 (측정 중) | 3 × 약 20 mA ≈ 60 mA |
| ESP32 (Wi-Fi 켜짐) | 평균 약 100 mA, 순간 최대 약 250 mA |
| 진동 모터 ×3 (전부 켜짐) | 3 × 약 80 mA ≈ 240 mA |

- **전원 경로 (11/11 결정):** USB(맥북 또는 보조배터리) → ESP32 마이크로 USB → ESP32 5V 핀 → 확장보드 V(5V) → 진동 모듈. 센서와 MPU-6050은 ESP32의 3.3V에서 받는다.
- 합계는 최대 약 550 mA다. 보조배터리 USB 단자(보통 1 A 이상)와 맥북 USB-C 단자로 충분하다.
- 처음 계획은 모터에 보조배터리를 따로 쓰는 것이었다 (모터 잡음 걱정). 확장보드로 배선이 단순해져서 **한 전원으로 시작**한다. 그 대신 확인 실험을 한다:
  - 모터가 돌 때 센서 값이 튀거나 ESP32가 재시작하는지 본다 (`02`로 모터 끔/켬 상태의 거리 표준편차 비교).
  - 문제가 있으면 먼저 모터 근처에 100 µF 커패시터를 단다. 그래도 문제면 모터만 다른 5V 전원으로 나누고 **GND만 공통**으로 묶는다. 결과를 일지에 남긴다.
- ESP32가 늘 약 100 mA를 쓰므로, 전류가 작으면 저절로 꺼지는 보조배터리 문제(`docs/parts.md`)도 줄어든다.
- 모듈의 모터가 **3V 정격**이면 5V를 그대로 걸 때 과열될 수 있다. 펌웨어의 `MAX_DUTY`로 평균 전압을 낮춘다 (출발점 150/255 ≈ 2.9V).
  모터 사양을 확인하고, 진동 세기와 발열을 보며 실험으로 최종값을 정한다.
- 모터 전원 근처에 **100 µF 전해 커패시터**를 달면 모터 잡음이 센서 측정에 끼어드는 것을 줄일 수 있다. 다리가 긴 쪽이 +(V), 띠가 있는 쪽이 −(G)다. 거꾸로 꽂으면 터질 수 있다.

## 4. 고개 각도 센서 (MPU-6050, GY-521 모듈)

| MPU-6050 | 연결 |
|---|---|
| VCC | ESP32는 **3.3V** (Mega·Uno는 5V. GY-521 모듈은 3.3V 레귤레이터 내장) |
| GND | GND |
| SDA, SCL | ESP32 SDA(21), SCL(22)에 **바로** 연결 (멀티플렉서를 거치지 않는다) |
| AD0 | GND → 주소 0x68 |

- 주소 0x68은 VL53L1X(0x29), 멀티플렉서(0x70)와 겹치지 않는다.
- 멀티플렉서 앞쪽(보드 쪽) 버스에 있으므로 `00_i2c_scan`에서 모든 채널에 0x68이 같이 보인다. 정상이다.
- 센서 바에 **단단히** 고정한다. 흔들리면 그 흔들림까지 각도로 잰다. 기판의 X축 화살표가 앞을 향하게 한다.
