danny50167/Space-to-Touch/(commit log)

2026-10-11 Add project docs, roadmap, and staged Arduino firmware
    - README with system overview, numbering convention, parts list
    - docs: design notes (sensor angle geometry, motor placement,
    distance-to-vibration encoding), wiring/power, weekly roadmap
    through Dec 2026, logbook template
    - firmware 01: single VL53L1X distance-mode and accuracy test
    - firmware 02: six sensors via TCA9548A, sequential vs continuous
    ranging comparison with per-sensor update rate
    - firmware 03: vibrotactile localization experiment with
    confusion matrix output
    - firmware 04: integrated device (median filter, hysteresis,
    pulse-rate encoding, fail-safe error pattern)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
    [01_single_sensor_test.ino, 02_six_sensors_mux.ino, 03_motor_localization_test.ino, 04_space_to_touch.ino]
2026-10-11 Add parts list, PLA mount design notes, and conic-section analysis
    - docs/parts.md: electronics, mechanical, and experiment checklist
    - design-notes: sensor FOV cone vs floor plane (ellipse/parabola/
    hyperbola by tilt), floor false-trigger check, PLA mount design
    (adjustable v1 -> fixed v2, vibration isolation, center of mass)
    - roadmap: report due end of December, phyphox vibration
    measurements, adjustable-angle mount step
    Claude-Session: https://claude.ai/code/session_0174QSjBd2CPcLAwQTs7y2G2
2026-10-11 Parts check: add inspection checklist, order timing, and I2C scan sketch
    - docs/parts.md: checklist for parts already on hand (VL53L1X vs VL53L0X,
    voltage/level shifting, protective film, motor rpm, phyphox sample rate),
    "needed by" week for each item, missing items (female-female jumpers,
    multimeter, spare motors, motor extension wire, compass, USB extension
    for the approach experiment), power-bank auto-off warning, record table
    - firmware/00_i2c_scan: scans the bus and each mux channel, reads the
    VL53L1X model ID to confirm the sensor type
    - README, roadmap: link the new sketch and checklist
    Claude-Session: https://claude.a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
    [00_i2c_scan.ino]
2026-10-11 Parts: record VL53L1X 5V compatibility, drop level-shifter order
    Claude-Session: https://claude.ai/code/session_016131LG8pFcfpy3vsG2hpAk
2026-10-11 Switch to MOSFET vibration motor modules
    The first coin motors had leads too thin to strip or solder, so the
    build moves to vibration motor modules with an on-board MOSFET driver
    (VCC, GND, IN; mounting holes). This removes the six hand-built
    transistor driver circuits.
    - parts.md: record the decision, order 8 modules, drop transistor,
    diode and base resistor rows, add jumper wires and module screws,
    arrival checklist (specs, circuit sketch, hole size, spin test)
    - wiring.md: module wiring (VCC from power bank, common GND, IN to PWM)
    and a circuit-observation task that keeps the back-EMF physics link
    - roadmap, README: update week 3 task and system diagram
    - firmware: MAX_DUTY / duty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
    [03_motor_localization_test.ino, 04_space_to_touch.ino]
2026-10-11 CLAUDE.md: add progress board artifact link and sync rule
    Claude-Session: https://claude.ai/code/session_01RsPJU6tXZvoBQ28KqQ9FAL
2026-10-11 Roadmap: replace weekly schedule with deadline-free task list
    Restructure docs/roadmap.md into ordered stages without weeks or due
    dates, tag subject experiments, and map parts.md timing to stages.
    CLAUDE.md and README follow the new structure and board data model.
    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
2026-10-12 Add 0° wedge block to head mount v1 for the parallel-placement test
    Claude-Session: https://claude.ai/code/session_01RYYAxogtBuEMry5sdbkYe8
2026-10-12 Switch sensor layout from 3x2 to a single 1x3 head-level row
    The device targets obstacles the white cane misses, and head level is
    the most injurious part of that zone. One row halves sensors, motors and
    wiring and lightens the head mount. The chest-to-waist band is given up
    and recorded as a limitation in design-notes 1-3/1-4.
    - firmware: 02 renamed to 02_three_sensors_mux, 03/04 use 3 motors
    (03 keeps 30 trials per site: 3 motors x 10)
    - design-notes: single-row tilt table, horizontal blind-strip formula
    (27 deg never closes the strip; compare with 25 deg), floor false-alarm
    condition is automatic when H > 1.5 m, draft motor-spacing variable
    - parts: motor modules x6 ordered (3 + 3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
2026-10-16 Design notes: how to get sensor spacing s, inverse fan-angle formula, head-top loss distance
    The previous guidance (upper edge >= head top for all x) can never hold
    near the sensor, because the sensor sits below the head top. Replace it
    with the distance x0 at which a head-top obstacle drops out of view.
    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
2026-10-16 Design notes: record sensor module dimensions from vendor drawing
    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
2026-10-16 Set side wedge starting point to 25 degrees
    27 deg leaves a sensor-spacing-wide blind strip that never closes;
    25 deg closes it at about 60 cm for s = 22 mm.
    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
2026-10-16 Add MPU-6050 head-tilt stage and 05_imu_tilt sketch
    The head pitch changes while walking and when the headband slips.
    05_imu_tilt prints accelerometer, gyro and complementary-filter pitch
    side by side plus the expected floor distance H / sin(theta + p + 13.5),
    which the integrated firmware will use to ignore floor readings.
    Drop-off warnings are out of scope (the white cane handles them).
    - roadmap: new stage 7 (IMU), later stages renumbered
    - design-notes 5, wiring 4, parts, README, CLAUDE.md updated
    - 3rd-year physics follow-up becomes filter error analysis / Kalman
    Claude-Session: https://claude.ai/code/session_01RYYAxogtBuEMry5sdb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
    [00_i2c_scan.ino, 05_imu_tilt.ino]
2026-10-16 Set vertical tilt starting point to 12 degrees (hinge range 0-15)
    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
2026-10-16 Start warnings at 2 m (levels 2.0 / 1.0 / 0.5 m)
    With H = 1.74 m < 2 m the floor can now enter the warning range when the
    head tilts down about 34 deg more; the MPU-6050 floor filter covers that.
    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
2026-10-16 Add TTC warning-hold as a calculus I task in the integration stage
    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
2026-10-16 Roadmap: add next-step tasks (orders, sensor pick, 2 m light check, holder test print, design log)
    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
2026-10-16 Use a GoPro-compatible head strap; tilt the sensor bar on its GoPro mount (M5) instead of a separate M3 hinge
    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
2026-10-16 Design notes: GY-521 (MPU-6050) dimensions, drawing and mounting guidance
    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
2026-10-19 Add reference STEP models for VL53L1X, its FoV cone and GY-521
    Generated with CadQuery from the vendor drawing and listed dimensions;
    assumed values are listed in cad/README.md and can be changed in
    make_reference.py once measured.
    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
    [gy521_mpu6050_ref.step, vl53l1x_fov_cone_60mm.step, vl53l1x_module_ref.step]
2026-11-10 Switch main board to ESP32 with Wi-Fi logging; vibration modules not yet ordered
    - Main board is now an ESP32 DevKitC (student's suggestion). Walking
    experiments (approach test, head tilt while walking, user test) need
    wireless logging; Mega/Uno stay as spares and all sketches still build
    for them.
    - 02/04/05 send output over USB and over Wi-Fi (ESP32 soft AP + TCP 2323,
    received on a MacBook with nc). Commands work from both sides.
    - ESP32 pins: I2C 21/22 at 3.3V, motors on GPIO 25/26/27. 03 uses the
    hardware RNG on ESP32.
    - Correct the parts list: the vibration modules were never ordered. Pick a
    module whose IN turns on with a 3.3V signal.
    - New docs/esp32.md: why ESP32, MacBoo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
    [00_i2c_scan.ino, 01_single_sensor_test.ino, 02_three_sensors_mux.ino, 03_motor_localization_test.ino, 04_space_to_touch.ino, 05_imu_tilt.ino, wifi_log.h]
2026-11-10 Finalize the parts order: ESP32 + expansion shield, ELB060416 modules, single power source
    - Order list in docs/parts.md: one Devicemart order (~106k KRW, free
    shipping over 66k) plus Coupang Rocket items (strap, GoPro thumb
    screws, calipers, hex keys, elastic velcro band, EVA foam).
    - Board: ESP32 DevKitC WROOM-32D V4 CP2102 x2 on a 38-pin terminal
    shield with G/V/S headers and a 5V/3.3V jumper. Vibration modules plug
    straight in (same GND/VCC/IN order).
    - Vibration module: ELB060416 x6 (3 mm holes, 15 mm pitch, 60 mA rated).
    3.3V signal backed by a Raspberry Pi GPIO review; 74HCT125 bought as a
    fallback level shifter, with wiring in docs/wiring.md.
    - Power now comes in through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
2026-11-11 Parts order: replace the 480pcs bolt kit with an M3 kit plus M2 singles
    M4 is unused and the kit was 30,800 KRW. The M3 kit (5-20 mm) plus M2
    8/10/12 mm bolts and nuts covers every hole for about 11,700 KRW.
    Hex key sizes corrected (M2 socket head 1.5 mm, M3 button head 2 mm).
    Claude-Session: https://claude.ai/code/session_01A3Ts7BkKprU4F1ewAhp3GE
2026-11-11 Parts order: buy M3 bolts singly instead of a 340pcs kit
    The build uses about 14 M3 bolts (vibration modules 6, GY-521 2, wedge
    blocks about 6). Phillips sems bolts with built-in washers: 10 mm x10 and
    16/20/25 mm x5 each, plus nuts. Separate washers dropped. Devicemart
    total is now about 79,000 KRW, still above the free-shipping line.
    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
2026-11-11 Parts order: Mac-to-ESP32 cable moves to Coupang (Coms IF001 sold out)
    The Nano cable is Mini-USB and does not fit the ESP32. Other Devicemart
    USB-C to micro cables do not state data support, so the cable is bought
    on Coupang with a rule: the listing must say data transfer (USB 2.0).
    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
2026-11-12 Parts order: drop the USB-A cable (power bank has a USB-C port)
    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
2026-11-13 Record the 11/13 purchases in a spreadsheet and update the order status
    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
    [purchases-2026-11.xlsx]
2026-11-13 Purchases sheet: fix grand total formula; existing USB-A cable + hub for the Mac
    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
    [purchases-2026-11.xlsx]
2026-11-13 Purchases sheet: drop the product code column
    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
    [purchases-2026-11.xlsx]
2026-11-13 CLAUDE.md: current status after ordering, shop access notes, user preferences
    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
2026-11-13 Layout: ESP32 on the back of the head, short I2C, battery in pocket
    Add design-notes 4-7 (what goes where, cable lengths, back plate,
    torque balance, voltage and I2C checks) and two roadmap tasks.
    Claude-Session: https://claude.ai/code/session_01A3Ts78Wfhysp3KqizqSRa2
